mark-parc/edge-carrier-rev-b/GerberFiles/Transcode Report.txt

   ---- Transcoding 'C:\Users\dpaley\Documents\EAGLE\projects\Edge Carrier Board Rev B\Gerbers\CAMOutputs\GerberFiles\copper_inner_l2.gbr' ----   Mon Oct 25 11:11:18 2021

D10   --> D100
D13   --> D101
D14   --> D102
D15   --> D103
D16   --> D104
D17   --> D105
D18   --> D106
D19   --> D107
D20   --> D108
D21   --> D109
D22   --> D110
D23   --> D111
D24   --> D112
D25   --> D113
D26   --> D114
D27   --> D115
D28   --> D116
-----------------------------------------------------------------

   ---- Transcoding 'C:\Users\dpaley\Documents\EAGLE\projects\Edge Carrier Board Rev B\Gerbers\CAMOutputs\GerberFiles\copper_inner_l3.gbr' ----   Mon Oct 25 11:11:18 2021

D10   --> D117
D13   --> D118
D14   --> D119
D15   --> D120
D16   --> D121
D17   --> D122
D18   --> D123
D19   --> D124
D20   --> D125
D21   --> D126
D22   --> D127
D23   --> D128
D24   --> D129
D25   --> D130
D26   --> D131
D27   --> D132
D28   --> D133
D29   --> D134
D30   --> D135
-----------------------------------------------------------------

   ---- Transcoding 'C:\Users\dpaley\Documents\EAGLE\projects\Edge Carrier Board Rev B\Gerbers\CAMOutputs\GerberFiles\copper_top_l1.gbr' ----   Mon Oct 25 11:11:18 2021

D10   --> D136
D11   --> D137
D12   --> D138
D13   --> D139
D14   --> D140
D15   --> D141
D16   --> D142
D17   --> D143
D18   --> D144
D19   --> D145
D20   --> D146
D21   --> D147
D22   --> D148
D23   --> D149
D24   --> D150
D25   --> D151
D26   --> D152
D27   --> D153
D28   --> D154
D29   --> D155
D30   --> D156
D31   --> D157
D32   --> D158
D33   --> D159
D34   --> D160
D35   --> D161
D36   --> D162
D37   --> D163
D38   --> D164
D39   --> D165
D40   --> D166
D41   --> D167
D42   --> D168
D43   --> D169
D44   --> D170
-----------------------------------------------------------------

   ---- Transcoding 'C:\Users\dpaley\Documents\EAGLE\projects\Edge Carrier Board Rev B\Gerbers\CAMOutputs\GerberFiles\profile.gbr' ----   Mon Oct 25 11:11:18 2021

D10   --> D171
D11   --> D172
-----------------------------------------------------------------

   ---- Transcoding 'C:\Users\dpaley\Documents\EAGLE\projects\Edge Carrier Board Rev B\Gerbers\CAMOutputs\GerberFiles\silkscreen_top.gbr' ----   Mon Oct 25 11:11:18 2021

D10   --> D173
D11   --> D174
D12   --> D175
D13   --> D176
D14   --> D177
D15   --> D178
D16   --> D179
D17   --> D180
D18   --> D181
D19   --> D182
D20   --> D183
D21   --> D184
D22   --> D185
D23   --> D186
D24   --> D187
D25   --> D188
D26   --> D189
D27   --> D190
D28   --> D191
D29   --> D192
D30   --> D193
D31   --> D194
D32   --> D195
D33   --> D196
D34   --> D197
D35   --> D198
D36   --> D199
D37   --> D200
D38   --> D201
D39   --> D202
D40   --> D203
D41   --> D204
D42   --> D205
D43   --> D206
D44   --> D207
D45   --> D208
D46   --> D209
D47   --> D210
D48   --> D211
D49   --> D212
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
-----------------------------------------------------------------

   ---- Transcoding 'C:\Users\dpaley\Documents\EAGLE\projects\Edge Carrier Board Rev B\Gerbers\CAMOutputs\GerberFiles\soldermask_bottom.gbr' ----   Mon Oct 25 11:11:18 2021

D10   --> D294
D11   --> D295
D12   --> D296
D13   --> D297
D14   --> D298
D15   --> D299
D16   --> D300
D17   --> D301
D18   --> D302
D19   --> D303
D20   --> D304
D21   --> D305
D22   --> D306
D23   --> D307
D24   --> D308
D25   --> D309
D26   --> D310
D27   --> D311
D28   --> D312
D29   --> D313
D30   --> D314
D31   --> D315
D32   --> D316
D33   --> D317
D34   --> D318
D35   --> D319
D36   --> D320
D37   --> D321
D38   --> D322
D39   --> D323
D40   --> D324
-----------------------------------------------------------------

   ---- Transcoding 'C:\Users\dpaley\Documents\EAGLE\projects\Edge Carrier Board Rev B\Gerbers\CAMOutputs\GerberFiles\soldermask_top.gbr' ----   Mon Oct 25 11:11:18 2021

D10   --> D325
D11   --> D326
D12   --> D327
D13   --> D328
D14   --> D329
D15   --> D330
D16   --> D331
D17   --> D332
D18   --> D333
D19   --> D334
D20   --> D335
D21   --> D336
D22   --> D337
D23   --> D338
D24   --> D339
D25   --> D340
D26   --> D341
D27   --> D342
D28   --> D343
D29   --> D344
D30   --> D345
D31   --> D346
D32   --> D347
D33   --> D348
D34   --> D349
D35   --> D350
D36   --> D351
D37   --> D352
D38   --> D353
D39   --> D354
D40   --> D355
D41   --> D356
D42   --> D357
D43   --> D358
D44   --> D359
D45   --> D360
D46   --> D361
D47   --> D362
D48   --> D363
D49   --> D364
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
-----------------------------------------------------------------

   ---- Transcoding 'C:\Users\dpaley\Documents\EAGLE\projects\Edge Carrier Board Rev B\Gerbers\CAMOutputs\GerberFiles\solderpaste_top.gbr' ----   Mon Oct 25 11:11:18 2021

D10   --> D404
D11   --> D405
D12   --> D406
D13   --> D407
D14   --> D408
D15   --> D409
D16   --> D410
D17   --> D411
D18   --> D412
D19   --> D413
D20   --> D414
D21   --> D415
D22   --> D416
D23   --> D417
D24   --> D418
D25   --> D419
D26   --> D420
D27   --> D421
D28   --> D422
D29   --> D423
D30   --> D424
D31   --> D425
D32   --> D426
D33   --> D427
D34   --> D428
D35   --> D429
D36   --> D430
D37   --> D431
D38   --> D432
D39   --> D433
D40   --> D434
D41   --> D435
D42   --> D436
D43   --> D437
D44   --> D438
D45   --> D439
D46   --> D440
D47   --> D441
D48   --> D442
D49   --> D443
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
-----------------------------------------------------------------

   ---- Transcoding 'C:\Users\dpaley\Documents\EAGLE\projects\Edge Carrier Board Rev B\Gerbers\CAMOutputs\GerberFiles\copper_inner_l2.gbr' ----   Mon Oct 25 11:23:57 2021

D10   --> D450
D13   --> D451
D14   --> D452
D15   --> D453
D16   --> D454
D17   --> D455
D18   --> D456
D19   --> D457
D20   --> D458
D21   --> D459
D22   --> D460
D23   --> D461
D24   --> D462
D25   --> D463
D26   --> D464
D27   --> D465
D28   --> D466
-----------------------------------------------------------------

   ---- Transcoding 'C:\Users\dpaley\Documents\EAGLE\projects\Edge Carrier Board Rev B\Gerbers\CAMOutputs\GerberFiles\copper_inner_l3.gbr' ----   Mon Oct 25 11:23:57 2021

D10   --> D467
D13   --> D468
D14   --> D469
D15   --> D470
D16   --> D471
D17   --> D472
D18   --> D473
D19   --> D474
D20   --> D475
D21   --> D476
D22   --> D477
D23   --> D478
D24   --> D479
D25   --> D480
D26   --> D481
D27   --> D482
D28   --> D483
D29   --> D484
D30   --> D485
-----------------------------------------------------------------

   ---- Transcoding 'C:\Users\dpaley\Documents\EAGLE\projects\Edge Carrier Board Rev B\Gerbers\CAMOutputs\GerberFiles\copper_top_l1.gbr' ----   Mon Oct 25 11:23:57 2021

D10   --> D486
D11   --> D487
D12   --> D488
D13   --> D489
D14   --> D490
D15   --> D491
D16   --> D492
D17   --> D493
D18   --> D494
D19   --> D495
D20   --> D496
D21   --> D497
D22   --> D498
D23   --> D499
D24   --> D500
D25   --> D501
D26   --> D502
D27   --> D503
D28   --> D504
D29   --> D505
D30   --> D506
D31   --> D507
D32   --> D508
D33   --> D509
D34   --> D510
D35   --> D511
D36   --> D512
D37   --> D513
D38   --> D514
D39   --> D515
D40   --> D516
D41   --> D517
D42   --> D518
D43   --> D519
D44   --> D520
-----------------------------------------------------------------

   ---- Transcoding 'C:\Users\dpaley\Documents\EAGLE\projects\Edge Carrier Board Rev B\Gerbers\CAMOutputs\GerberFiles\profile.gbr' ----   Mon Oct 25 11:23:57 2021

D10   --> D521
D11   --> D522
-----------------------------------------------------------------

   ---- Transcoding 'C:\Users\dpaley\Documents\EAGLE\projects\Edge Carrier Board Rev B\Gerbers\CAMOutputs\GerberFiles\silkscreen_top.gbr' ----   Mon Oct 25 11:23:57 2021

D10   --> D523
D11   --> D524
D12   --> D525
D13   --> D526
D14   --> D527
D15   --> D528
D16   --> D529
D17   --> D530
D18   --> D531
D19   --> D532
D20   --> D533
D21   --> D534
D22   --> D535
D23   --> D536
D24   --> D537
D25   --> D538
D26   --> D539
D27   --> D540
D28   --> D541
D29   --> D542
D30   --> D543
D31   --> D544
D32   --> D545
D33   --> D546
D34   --> D547
D35   --> D548
D36   --> D549
D37   --> D550
D38   --> D551
D39   --> D552
D40   --> D553
D41   --> D554
D42   --> D555
D43   --> D556
D44   --> D557
D45   --> D558
D46   --> D559
D47   --> D560
D48   --> D561
D49   --> D562
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
-----------------------------------------------------------------

   ---- Transcoding 'C:\Users\dpaley\Documents\EAGLE\projects\Edge Carrier Board Rev B\Gerbers\CAMOutputs\GerberFiles\soldermask_bottom.gbr' ----   Mon Oct 25 11:23:57 2021

D10   --> D644
D11   --> D645
D12   --> D646
D13   --> D647
D14   --> D648
D15   --> D649
D16   --> D650
D17   --> D651
D18   --> D652
D19   --> D653
D20   --> D654
D21   --> D655
D22   --> D656
D23   --> D657
D24   --> D658
D25   --> D659
D26   --> D660
D27   --> D661
D28   --> D662
D29   --> D663
D30   --> D664
D31   --> D665
D32   --> D666
D33   --> D667
D34   --> D668
D35   --> D669
D36   --> D670
D37   --> D671
D38   --> D672
D39   --> D673
D40   --> D674
-----------------------------------------------------------------

   ---- Transcoding 'C:\Users\dpaley\Documents\EAGLE\projects\Edge Carrier Board Rev B\Gerbers\CAMOutputs\GerberFiles\soldermask_top.gbr' ----   Mon Oct 25 11:23:57 2021

D10   --> D675
D11   --> D676
D12   --> D677
D13   --> D678
D14   --> D679
D15   --> D680
D16   --> D681
D17   --> D682
D18   --> D683
D19   --> D684
D20   --> D685
D21   --> D686
D22   --> D687
D23   --> D688
D24   --> D689
D25   --> D690
D26   --> D691
D27   --> D692
D28   --> D693
D29   --> D694
D30   --> D695
D31   --> D696
D32   --> D697
D33   --> D698
D34   --> D699
D35   --> D700
D36   --> D701
D37   --> D702
D38   --> D703
D39   --> D704
D40   --> D705
D41   --> D706
D42   --> D707
D43   --> D708
D44   --> D709
D45   --> D710
D46   --> D711
D47   --> D712
D48   --> D713
D49   --> D714
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
-----------------------------------------------------------------

   ---- Transcoding 'C:\Users\dpaley\Documents\EAGLE\projects\Edge Carrier Board Rev B\Gerbers\CAMOutputs\GerberFiles\solderpaste_top.gbr' ----   Mon Oct 25 11:23:57 2021

D10   --> D754
D11   --> D755
D12   --> D756
D13   --> D757
D14   --> D758
D15   --> D759
D16   --> D760
D17   --> D761
D18   --> D762
D19   --> D763
D20   --> D764
D21   --> D765
D22   --> D766
D23   --> D767
D24   --> D768
D25   --> D769
D26   --> D770
D27   --> D771
D28   --> D772
D29   --> D773
D30   --> D774
D31   --> D775
D32   --> D776
D33   --> D777
D34   --> D778
D35   --> D779
D36   --> D780
D37   --> D781
D38   --> D782
D39   --> D783
D40   --> D784
D41   --> D785
D42   --> D786
D43   --> D787
D44   --> D788
D45   --> D789
D46   --> D790
D47   --> D791
D48   --> D792
D49   --> D793
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
-----------------------------------------------------------------

   ---- Transcoding 'C:\Users\dpaley\Documents\EAGLE\projects\Edge Carrier Board Rev B\Gerbers\CAMOutputs\GerberFiles\copper_inner_l2.gbr' ----   Mon Oct 25 11:24:54 2021

D10   --> D100
D13   --> D101
D14   --> D102
D15   --> D103
D16   --> D104
D17   --> D105
D18   --> D106
D19   --> D107
D20   --> D108
D21   --> D109
D22   --> D110
D23   --> D111
D24   --> D112
D25   --> D113
D26   --> D114
D27   --> D115
D28   --> D116
-----------------------------------------------------------------

   ---- Transcoding 'C:\Users\dpaley\Documents\EAGLE\projects\Edge Carrier Board Rev B\Gerbers\CAMOutputs\GerberFiles\copper_inner_l3.gbr' ----   Mon Oct 25 11:24:54 2021

D10   --> D117
D13   --> D118
D14   --> D119
D15   --> D120
D16   --> D121
D17   --> D122
D18   --> D123
D19   --> D124
D20   --> D125
D21   --> D126
D22   --> D127
D23   --> D128
D24   --> D129
D25   --> D130
D26   --> D131
D27   --> D132
D28   --> D133
D29   --> D134
D30   --> D135
-----------------------------------------------------------------

   ---- Transcoding 'C:\Users\dpaley\Documents\EAGLE\projects\Edge Carrier Board Rev B\Gerbers\CAMOutputs\GerberFiles\copper_top_l1.gbr' ----   Mon Oct 25 11:24:54 2021

D10   --> D136
D11   --> D137
D12   --> D138
D13   --> D139
D14   --> D140
D15   --> D141
D16   --> D142
D17   --> D143
D18   --> D144
D19   --> D145
D20   --> D146
D21   --> D147
D22   --> D148
D23   --> D149
D24   --> D150
D25   --> D151
D26   --> D152
D27   --> D153
D28   --> D154
D29   --> D155
D30   --> D156
D31   --> D157
D32   --> D158
D33   --> D159
D34   --> D160
D35   --> D161
D36   --> D162
D37   --> D163
D38   --> D164
D39   --> D165
D40   --> D166
D41   --> D167
D42   --> D168
D43   --> D169
D44   --> D170
-----------------------------------------------------------------

   ---- Transcoding 'C:\Users\dpaley\Documents\EAGLE\projects\Edge Carrier Board Rev B\Gerbers\CAMOutputs\GerberFiles\profile.gbr' ----   Mon Oct 25 11:24:54 2021

D10   --> D171
D11   --> D172
-----------------------------------------------------------------

   ---- Transcoding 'C:\Users\dpaley\Documents\EAGLE\projects\Edge Carrier Board Rev B\Gerbers\CAMOutputs\GerberFiles\silkscreen_top.gbr' ----   Mon Oct 25 11:24:54 2021

D10   --> D173
D11   --> D174
D12   --> D175
D13   --> D176
D14   --> D177
D15   --> D178
D16   --> D179
D17   --> D180
D18   --> D181
D19   --> D182
D20   --> D183
D21   --> D184
D22   --> D185
D23   --> D186
D24   --> D187
D25   --> D188
D26   --> D189
D27   --> D190
D28   --> D191
D29   --> D192
D30   --> D193
D31   --> D194
D32   --> D195
D33   --> D196
D34   --> D197
D35   --> D198
D36   --> D199
D37   --> D200
D38   --> D201
D39   --> D202
D40   --> D203
D41   --> D204
D42   --> D205
D43   --> D206
D44   --> D207
D45   --> D208
D46   --> D209
D47   --> D210
D48   --> D211
D49   --> D212
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
-----------------------------------------------------------------

   ---- Transcoding 'C:\Users\dpaley\Documents\EAGLE\projects\Edge Carrier Board Rev B\Gerbers\CAMOutputs\GerberFiles\soldermask_bottom.gbr' ----   Mon Oct 25 11:24:54 2021

D10   --> D294
D11   --> D295
D12   --> D296
D13   --> D297
D14   --> D298
D15   --> D299
D16   --> D300
D17   --> D301
D18   --> D302
D19   --> D303
D20   --> D304
D21   --> D305
D22   --> D306
D23   --> D307
D24   --> D308
D25   --> D309
D26   --> D310
D27   --> D311
D28   --> D312
D29   --> D313
D30   --> D314
D31   --> D315
D32   --> D316
D33   --> D317
D34   --> D318
D35   --> D319
D36   --> D320
D37   --> D321
D38   --> D322
D39   --> D323
D40   --> D324
-----------------------------------------------------------------

   ---- Transcoding 'C:\Users\dpaley\Documents\EAGLE\projects\Edge Carrier Board Rev B\Gerbers\CAMOutputs\GerberFiles\soldermask_top.gbr' ----   Mon Oct 25 11:24:54 2021

D10   --> D325
D11   --> D326
D12   --> D327
D13   --> D328
D14   --> D329
D15   --> D330
D16   --> D331
D17   --> D332
D18   --> D333
D19   --> D334
D20   --> D335
D21   --> D336
D22   --> D337
D23   --> D338
D24   --> D339
D25   --> D340
D26   --> D341
D27   --> D342
D28   --> D343
D29   --> D344
D30   --> D345
D31   --> D346
D32   --> D347
D33   --> D348
D34   --> D349
D35   --> D350
D36   --> D351
D37   --> D352
D38   --> D353
D39   --> D354
D40   --> D355
D41   --> D356
D42   --> D357
D43   --> D358
D44   --> D359
D45   --> D360
D46   --> D361
D47   --> D362
D48   --> D363
D49   --> D364
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
-----------------------------------------------------------------

   ---- Transcoding 'C:\Users\dpaley\Documents\EAGLE\projects\Edge Carrier Board Rev B\Gerbers\CAMOutputs\GerberFiles\solderpaste_top.gbr' ----   Mon Oct 25 11:24:54 2021

D10   --> D404
D11   --> D405
D12   --> D406
D13   --> D407
D14   --> D408
D15   --> D409
D16   --> D410
D17   --> D411
D18   --> D412
D19   --> D413
D20   --> D414
D21   --> D415
D22   --> D416
D23   --> D417
D24   --> D418
D25   --> D419
D26   --> D420
D27   --> D421
D28   --> D422
D29   --> D423
D30   --> D424
D31   --> D425
D32   --> D426
D33   --> D427
D34   --> D428
D35   --> D429
D36   --> D430
D37   --> D431
D38   --> D432
D39   --> D433
D40   --> D434
D41   --> D435
D42   --> D436
D43   --> D437
D44   --> D438
D45   --> D439
D46   --> D440
D47   --> D441
D48   --> D442
D49   --> D443
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
-----------------------------------------------------------------
