mark-parc/edge-carrier-rev-b/block diagram.pptx

CM4 Module
(sheet 1)

Ethernet
(sheet 2,9,10)

USB
(sheet 7)

RTC
(sheet6)

Debug
(HDMI/USB OTG)
(sheet 3,6)

Power Regulation
Watchdog
(sheet 5,8)
