mark-parc/edge-carrier-rev-b/Assembly/Compute Module BOM.xlsx

Qty | Parts | Value | Description | DIGIKEY | MANUFACTURER | MOUSER | MPN | Device
2 | R34, R35 |  | Generic Resistor Package | 311-0.0ARCT-ND |  |  | RC0805JR-070RL | EDGE-LIBRARY_RESISTOR0805
28 | C2, C3, C8, C9, C28, C29, C30, C33, C34, C35, C36, C37, C38, C43, C45, C56, C57, C59, C60, C61, C62, C63, C65, C66, C67, C74, C78, C94 | 0.1uF | Capacitor - Generic | 399-3521-1-ND | Kemet |  | C0402C104K4RACTU | EDGE-LIBRARY_TUTORIAL---FUSION-360_CCHIP-0402(1005-METRIC)
1 | R10 | 10.5k | Resistor Fixed - ANSI | YAG2951CT-ND | Yageo |  | RC0402FR-0710K5L | EDGE-LIBRARY_TUTORIAL---FUSION-360_R-USCHIP-0402(1005-METRIC)
5 | C6, C7, C42, C75, C95 | 10000pF | Capacitor - Generic | 1253-CM02X5R103M16AHCT-ND | AVX Corporation |  | CM02X5R103M16AH | EDGE-LIBRARY_TUTORIAL---FUSION-360_CCHIP-0402(1005-METRIC)
1 | C23 | 100uF | Wurth Elektronik 100uF 6.3V dc Aluminium Polymer Capacitor, Surface Mount 7.3 x 4.3 x 1.9mm +105C 7.3mm | 732-13327-1-nd | Wurth Elektronik | 710-875015119003 | 875015119003 | 875015119003
6 | R9, R33, R40, R51, R53, R55 | 10k | Resistor Fixed - ANSI | 2571-RM04J103CTTR-ND | CAL-CHIP ELECTRONICS, INC. |  | RM04J103CT | EDGE-LIBRARY_TUTORIAL---FUSION-360_R-USCHIP-0402(1005-METRIC)
1 | C44 | 10pF | Capacitor - Generic | 399-3521-1-ND | Kyocera Avx |  | 478-04026D100JAT2ACT-ND | EDGE-LIBRARY_TUTORIAL---FUSION-360_CCHIP-0402(1005-METRIC)
13 | C4, C5, C10, C25, C26, C27, C31, C32, C41, C47, C64, C76, C96 | 10uF | Capacitor - Generic | 490-14381-1-ND | Murata Electronics |  | GRM21BR71A106KA73K | EDGE-LIBRARY_TUTORIAL---FUSION-360_CCHIP-0402(1005-METRIC)
2 | R14, R28 | 115k | Resistor Fixed - ANSI | A127517CT-ND | TE Connectivity |  | RP73PF1E115KBTD | EDGE-LIBRARY_TUTORIAL---FUSION-360_R-USCHIP-0402(1005-METRIC)
1 | R52 | 12k | Resistor Fixed - ANSI | 311-12.0KLRCT-ND | Stackpole Electronics Inc |  | RC0402FR-0712KL | EDGE-LIBRARY_TUTORIAL---FUSION-360_R-USCHIP-0402(1005-METRIC)
3 | R8, R26, R29 | 12k | Resistor Fixed - ANSI | 311-12.0KLRCT-ND | Yageo |  | RC0402FR-0712KL | EDGE-LIBRARY_TUTORIAL---FUSION-360_R-USCHIP-0402(1005-METRIC)
1 | C46 | 12pF | Capacitor - Generic | 478-04026A120KAT2ACT-ND | Kyocera Avx |  | 04026A120KAT2A | EDGE-LIBRARY_TUTORIAL---FUSION-360_CCHIP-0402(1005-METRIC)
3 | R2, R11, R36 | 15.8k | Resistor Fixed - ANSI | 541-15.8KLCT-ND | Vishay Dale |  | CRCW040215K8FKED | EDGE-LIBRARY_TUTORIAL---FUSION-360_R-USCHIP-0402(1005-METRIC)
1 | R16 | 15k | Resistor Fixed - ANSI | RMCF0402FT15K0CT-ND | Stackpole Electronics Inc |  | RMCF0402FT15K0 | EDGE-LIBRARY_TUTORIAL---FUSION-360_R-USCHIP-0402(1005-METRIC)
2 | C48, C73 | 15pF | Capacitor - Generic | 2571-GMC04CG150J50NTTR-ND | CAL-CHIP ELECTRONICS, INC. |  | GMC04CG150J50NT | EDGE-LIBRARY_TUTORIAL---FUSION-360_CCHIP-0402(1005-METRIC)
2 | C54, C55 | 16pF | Capacitor - Generic | 399-C0402C160K3HACAUTOCT-ND | Kemet |  | C0402C160K3HACAUTO | EDGE-LIBRARY_TUTORIAL---FUSION-360_CCHIP-0402(1005-METRIC)
1 | X1 | 1751248 | MKDS 1/ 2-3,5 Printklemme |  |  |  |  | 1751248
4 | C77, C79, C80, C82 | 1uF | Capacitor - Generic | 2873-C0402B105K016TCT-ND | Holy Stone Enterprise Co., Ltd. |  | C0402B105K016T | EDGE-LIBRARY_TUTORIAL---FUSION-360_CCHIP-0402(1005-METRIC)
2 | R24, R25 | 2.2k | Resistor Fixed - ANSI | 2571-RM04J222CTTR-ND | CAL-CHIP ELECTRONICS, INC. |  | RM04J222CT | EDGE-LIBRARY_TUTORIAL---FUSION-360_R-USCHIP-0402(1005-METRIC)
1 | J2 | 2011-1X03G00SD025B | PIN HEADER | 2553-2011-1X03G00SB-ND | Oupiin |  | 2011-1X03G00SB | CON-LSTB_MA03-1
1 | J4 | 2011-2X07G00SB | PIN HEADER | 2553-2011-2X07G00SB-ND | Oupiin |  | 2011-2X07G00SB | CON-LSTB_MA07-2
4 | R3, R15, R32, R38 | 22.1k | Resistor Fixed - ANSI | 2571-RN04D2212CT10-25TR-ND | CAL-CHIP ELECTRONICS, INC. |  | RN04D2212CT10-25 | EDGE-LIBRARY_TUTORIAL---FUSION-360_R-USCHIP-0402(1005-METRIC)
1 | R13 | 22k | Resistor Fixed - ANSI | 2571-RM04J222CTTR-ND | CAL-CHIP ELECTRONICS, INC. |  | RM04J223CT | EDGE-LIBRARY_TUTORIAL---FUSION-360_R-USCHIP-0402(1005-METRIC)
19 | C1, C17, C18, C19, C20, C21, C22, C24, C51, C52, C53, C68, C69, C70, C81, C87, C88, C89, C90 | 22uF | Capacitor - Generic | 2571-GMC04X5R226M6R3NTTR-ND | CAL-CHIP ELECTRONICS, INC. |  | GMC04X5R226M6R3NT | EDGE-LIBRARY_TUTORIAL---FUSION-360_CCHIP-0402(1005-METRIC)
1 | J13 | 2553-2011-1X03G00SB-ND | PIN HEADER | 2553-2011-1X03G00SB-ND | Oupiin |  | 2011-1X03G00SB | CON-LSTB_MA03-1
5 | C13, C14, C49, C72, C92 | 2700pF | Capacitor - Generic | 2571-GMC04X5R272M50NTTR-ND | CAL-CHIP ELECTRONICS, INC. |  | GMC04X5R272M50NT | EDGE-LIBRARY_TUTORIAL---FUSION-360_CCHIP-0402(1005-METRIC)
2 | C39, C40 | 27pF | Capacitor - Generic | 490-17672-1-ND | Murata Electronics |  | GJM1555C1H270JB01D | EDGE-LIBRARY_TUTORIAL---FUSION-360_CCHIP-0402(1005-METRIC)
1 | R54 | 2k | Resistor Fixed - ANSI | RMCF0402JT2K00CT-ND | Stackpole Electronics Inc |  | RMCF0402JT2K00 | EDGE-LIBRARY_TUTORIAL---FUSION-360_R-USCHIP-0402(1005-METRIC)
1 | L7 | 3.3uH 1.5A 70m | SMT Power Inductor | 732-5494-1-ND | Wurth Elektronik |  | 74404032033 | 74404032033
2 | R1, R31 | 309k | Resistor Fixed - ANSI | 2571-RM04F3093CTTR-ND | CAL-CHIP ELECTRONICS, INC. |  | RM04F3093CT | EDGE-LIBRARY_TUTORIAL---FUSION-360_R-USCHIP-0402(1005-METRIC)
1 | D1 | 30V 200MA | Schottky Diodes | BAT54C-FDICT-ND | Diodes Incorporated |  | BAT54C-7-F | EDGE-LIBRARY_BAT54C
2 | C12, C93 | 33pF | Capacitor - Generic | 2571-GMC04CG330J16NTTR-ND | CAL-CHIP ELECTRONICS, INC. |  | GMC04CG330J16NT | EDGE-LIBRARY_TUTORIAL---FUSION-360_CCHIP-0402(1005-METRIC)
4 | R21, R22, R23, R27 | 36k | Resistor Fixed - ANSI | 311-36.0KLRCT-ND | Yageo |  | RC0402FR-0736KL | EDGE-LIBRARY_TUTORIAL---FUSION-360_R-USCHIP-0402(1005-METRIC)
1 | R30 | 37.4k | Resistor Fixed - ANSI | 2571-RM04F3742CTTR-ND | CAL-CHIP ELECTRONICS, INC. |  | RM04F3742CT | EDGE-LIBRARY_TUTORIAL---FUSION-360_R-USCHIP-0402(1005-METRIC)
10 | R4, R5, R6, R7, R17, R18, R41, R48, R49, R50 | 470 | Resistor Fixed - ANSI | 311-470LRCT-ND | Yageo |  | RC0402FR-07470RL | EDGE-LIBRARY_TUTORIAL---FUSION-360_R-USCHIP-0402(1005-METRIC)
2 | R19, R20 | 510k | Resistor Fixed - ANSI | RMCF0402JT510KCT-ND | Stackpole Electronics Inc |  | RMCF0402JT510K | EDGE-LIBRARY_TUTORIAL---FUSION-360_R-USCHIP-0402(1005-METRIC)
1 | C11 | 56pF | Capacitor - Generic | 587-6134-1-ND | Taiyo Yuden |  | EMK042CG560JC-W | EDGE-LIBRARY_TUTORIAL---FUSION-360_CCHIP-0402(1005-METRIC)
1 | J6 | 67996-140HLF | AMPHENOL ICC (FCI) - 67996-140HLF - CONNECTOR, HEADER, 40POS, 2ROW, 2.54MM | 609-4925-ND | Amphenol | 649-67996-140HLF | 67996-140HLF | 67996-140HLF
1 | R12 | 69.8k | Resistor Fixed - ANSI | RMCF0402FT69K8CT-ND | Stackpole Electronics Inc |  | RMCF0402FT69K8 | EDGE-LIBRARY_TUTORIAL---FUSION-360_R-USCHIP-0402(1005-METRIC)
4 | C83, C84, C85, C86 | DNP | Capacitor - Generic | 399-3521-1-ND | Kemet |  | C0402C104K4RACTU | EDGE-LIBRARY_TUTORIAL---FUSION-360_CCHIP-0402(1005-METRIC)
5 | C15, C16, C50, C71, C91 | DNP | Capacitor - Generic |  |  |  |  | EDGE-LIBRARY_TUTORIAL---FUSION-360_CCHIP-0402(1005-METRIC)
2 | U4, U11 | EDGE-LIBRARY_74LVC1G07SE-7 | Check prices | 74LVC1G07SE-7DICT-ND | Diodes Inc |  | 74LVC1G07SE-7 | EDGE-LIBRARY_74LVC1G07SE-7
1 | Y2 | EDGE-LIBRARY_ABM8-24.000MHZ-B2-T_ABM8-24.000MHZ-B2-T | Crystal 24MHz Â±20ppm (Tol) Â±30ppm (Stability) 18pF FUND 80Ohm 4-Pin Mini-CSMD T/R | 535-9138-1-ND | Abracon |  | ABM8-24.000MHZ-B2-T | EDGE-LIBRARY_ABM8-24.000MHZ-B2-T_ABM8-24.000MHZ-B2-T
1 | U9 | EDGE-LIBRARY_AP2553AW6-7 |  | 31-AP22653AW6-7CT-ND | Diodes Incorporated |  | AP22653AW6-7 | EDGE-LIBRARY_AP2553AW6-7
5 | U3, U7, U8, U15, U20 | EDGE-LIBRARY_AP64501_AP64501 |  | AP64501SP-13CT-ND | Diodes Incorporated |  | AP64501SP-13 | EDGE-LIBRARY_AP64501_AP64501
1 | BT1 | EDGE-LIBRARY_BATTERY_HOLDER | BATTERY RETAINER COIN 20MM SMD | 732-12323-2-ND | Wurth Electronics Inc. |  | 79523141 | EDGE-LIBRARY_BATTERY_HOLDER
1 | J7 | EDGE-LIBRARY_HDMI_CONNECTOR_RT_SMA | HDMI Connector | Right Angle | Without Flange | -20C to 85C | 380-SS-53000-001-ND | Stewart Connector |  | SS-53000-001 | EDGE-LIBRARY_HDMI_CONNECTOR_RT_SMA
2 | J5, J17 | EDGE-LIBRARY_L836-1J1T-43_L836-1J1T-43 | 1X1 | GIGABIT | Tab Down | Low Profile | With LED | 507-2236-ND | Bel Magnetic Solutions |  | L836-1J1T-43 | EDGE-LIBRARY_L836-1J1T-43_L836-1J1T-43
1 | D3 | EDGE-LIBRARY_MMBZ5242BLT3G | Diode Ziner 12V 225mW SOT23-3 | MMBZ5242BLT3GOSCT-ND | On Semiconductor |  | MMBZ5242BLT3G | EDGE-LIBRARY_MMBZ5242BLT3G
1 | J9 | EDGE-LIBRARY_PCIE_CONNECTOR_36POS | Conn PCI Express Card Edge SKT 36 POS 2mm Solder ST Thru-Hole Tray | 609-2029-ND | Amphenol ICC |  | 10018784-10210TLF | EDGE-LIBRARY_PCIE_CONNECTOR_36POS
2 | MOD1 | EDGE-LIBRARY_RPI-CM4 |  | H11615CT-ND | Hirose Electric Co Ltd |  | DF40C-0.4V(51) | EDGE-LIBRARY_RPI-CM4
3 | L1, L3, L4 | EDGE-LIBRARY_SRN6045TA-3R3Y_SRN6045TA-3R3Y | Inductor Power Semi-Shielded Wirewound 220uH 20% 1MHz 15Q-Factor Ferrite 600mA 900mOhm DCR 2424 Automotive T/R | SRN6045TA-3R3YCT-ND | Bourns |  | SRN6045TA-3R3Y | EDGE-LIBRARY_SRN6045TA-3R3Y_SRN6045TA-3R3Y
2 | L2, L5 | EDGE-LIBRARY_SRN6045TA-3R3Y_SRN6045TA-3R3Y | Inductor Power Semi-Shielded Wirewound 220uH 20% 1MHz 15Q-Factor Ferrite 600mA 900mOhm DCR 2424 Automotive T/R | SRN6045TA-6R8MCT-ND | Bourns |  | SRN6045TA-6R8M | EDGE-LIBRARY_SRN6045TA-3R3Y_SRN6045TA-3R3Y
6 | U1, U2, U12, U18, U19, U21 | EDGE-LIBRARY_TPD4EUSB30DQAR_TPD4EUSB30DQAR | 4-channel ESD solution for SuperSpeed (6 Gbps) USB 3.0 interface 10-USON -40 to 85 | 296-28063-1-ND | Texas Instruments |  | TPD4EUSB30DQAR | EDGE-LIBRARY_TPD4EUSB30DQAR_TPD4EUSB30DQAR
1 | U13 | EDGE-LIBRARY_USB2514B-I_M2_USB2514B-I/M2 | None Check prices | USB2514B-I/M2-ND | Microchip |  | USB2514B-I/M2 | EDGE-LIBRARY_USB2514B-I_M2_USB2514B-I/M2
1 | J14 | EDGE-LIBRARY_USB_A_2PORT_STACKED_SMA | Conn USB Type A RCP 4/4 POS Solder RA Thru-Hole 8 Terminal 2 Port Tray | WM17130-ND | Molex |  | 672984090 | EDGE-LIBRARY_USB_A_2PORT_STACKED_SMA
1 | U14 | FSUSB42UMX | IC, Fairchild, FSUSB42UMX |  |  |  |  | FSUSB42UMX
2 | J3, J16 | L712RAS_L712RAS | Power Barrel Connector Jack 2.50mm ID (0.098), 5.50mm OD (0.217") Panel Mount, Through Hole, Right Angle Check prices" | SC1394-ND | Switchcraft |  | L712RAS | L712RAS_L712RAS
1 | U16 | LAN7800-I_VSX | USB Interface IC USB3.1 Gen1 to 10/100/1000 Ethernet Bridge, Industrial temp. | LAN7800-I/VSX-ND | Microchip |  | LAN7800-I/VSX | LAN7800-I_VSX
4 | LED1, LED2, LED3, LED4 | LTST-S270KGKT | LED | LTST-S270KGKT | Lite-On Inc |  | LTST-S270KGKT | LED_LEDCHIP-LED0603
1 | U10 | MCP7940N-E_MS | Real Time Clock I2C GP RTCC 64B SRAM , EXT | MCP7940NT-E/MSCT-ND | Microchip | 579-MCP7940N-E/MS | MCP7940N-E/MS | MCP7940N-E_MS
1 | U5 | MIC2025-2YMM | Power Switch ICs - Power Distribution USB High-Side Power Switch | MIC2025-2YM-CT-ND | Microchip | 998-MIC2025-2YMM | MIC2025-2YMM | MIC2025-2YMM
7 | MGT7, MGT8, MGT9, MGT10, MGT11, MGT12, MGT13 | MOUNTING_HOLE | Chassis Mounting Hole w/GND connection ability |  |  |  |  | MOUNTING_HOLE
7 | MGT1, MGT2, MGT3, MGT4, MGT5, MGT6, MGT14 | MOUNTING_HOLE | Chassis Mounting Hole w/GND connection ability | DNP |  |  |  | MOUNTING_HOLE
1 | JP1 | PINHD-2X5 | PIN HEADER | 2553-2011-2X05G00SB-ND | Oupiin |  | 2011-2X05G00SB | PINHD-2X5
1 | Q2 | RQ3E120ATTB | RQ3E100ATTB P-Channel MOSFET, 31 A, 30 V RQ3E100AT, 8-Pin HSMT ROHM | RQ3E120ATTBCT-ND | ROHM Semiconductor | 755-RQ3E100ATTB | RQ3E100ATTB | RQ3E120ATTB
1 | U17 | SAMACSYS_PARTS_93AA66AT-I_OT | 4K, 512 X 8 SERIAL EEPROM,1.8V,IND | 93AA66AT-I/OTCT-ND | Microchip |  | 93AA66AT-I/OT | SAMACSYS_PARTS_93AA66AT-I_OT
1 | Y3 | SAMACSYS_PARTS_ABM8G-25.000MHZ-B4Y-T3 | ABRACON - ABM8G-25.000MHZ-B4Y-T3 - CRYSTAL, 25MHZ, 10PF, 3.2MM X 2.5MM | 535-14315-1-ND | ABRACON |  | ABM8G-25.000MHZ-B4Y-T3 | SAMACSYS_PARTS_ABM8G-25.000MHZ-B4Y-T3
1 | FB6 | SAMACSYS_PARTS_BLM18PG121SN1D | Ferrite bead SMD 0603 120R 2A Murata Ferrite Bead (Chip Ferrite Bead), 1.6 x 0.8 x 0.8mm (0603), 120 impedance at 100 MHz | 490-1037-1-ND | Murata Electronics |  | BLM18PG121SN1D | SAMACSYS_PARTS_BLM18PG121SN1D
1 | U6 | SAMACSYS_PARTS_TPS3850G33DRCT | Precision window supervisor for OV & UV monitoring with window watchdog timer & programmable delay | 2156-TPS3850G33DRCR-ND | Texas Instruments |  | TPS3850G33DRCT | SAMACSYS_PARTS_TPS3850G33DRCT
3 | LED5, LED6, LED7 | TLPR5600 | LED S.VIEW RED TINT. DIFF-e4 | DNP | Vishay | DNP | TLPR5600 | TLPR5600
1 | J19 | TSW-103-07-L-T | CONN HEADER 9 POS .100";";";";";";SAM15360-ND" |  |  |  |  | TSW-103-07-L-T
3 | FB1, FB2, FB3 | WLBD2012HCU121TH791-WLBD2012HCU121TH | Ferrite bead SMD 0603 120R 2A Murata Ferrite Bead (Chip Ferrite Bead), 1.6 x 0.8 x 0.8mm (0603), 120 impedance at 100 MHz |  | Waisin | 791-WLBD2012HCU121TH | WLBD2012HCU121TH | WLBD2012HCU121TH791-WLBD2012HCU121TH
1 | Y1 | XTAL32.7682-SMD |  | 3003-QT3C-32.768KDZY-T-ND | QST |  | QT3C-32.768KDZY-T | XTAL32.7682-SMD
1 | J18 | ZX62-B-5PA_33_ | USB Connectors MICRO B RECEPT RA SMT BTTM MNT | H125270CT-ND | Hirose |  | ZX62-B-5PA(33) | ZX62-B-5PA_33_
