mark-parc/edge-carrier-rev-b/Compute Module.dxf

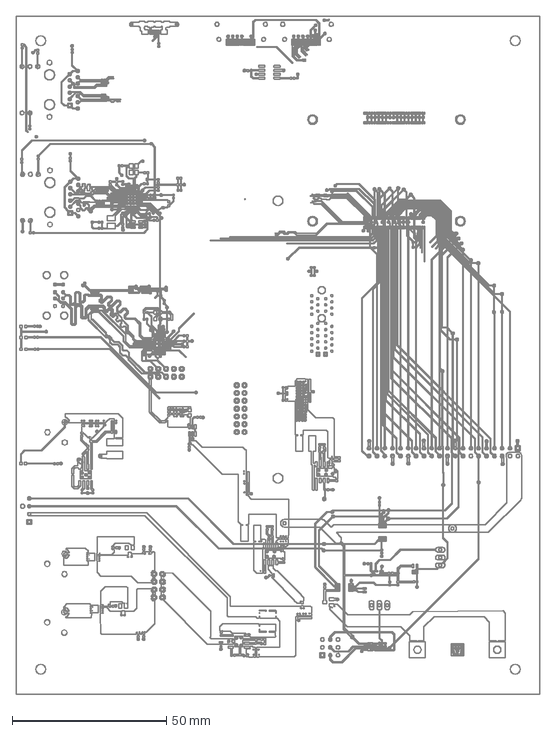
[picture p2: CAD file, 2022-02-08]
Compute Module.dxf
170.0 x 220.0 mm
