mark-parc/edge-carrier-rev-b/Release Notes.rtf

Release Notes (starting with Board Rev B)

DNP: 7/8/2021 –
Incorrect parts specified for U5, J18, and 22uF caps. The only one I cannot fix is the U5 (MIC2025) as the footprint of the part I have is an SOIC and not 8MSOP. Board was modified to change this footprint
Polygon thermals were turned off. This closes the gap around pins and vias.
MAS: 12/13/2021 –
- Moved U5 to the ground plane.
- Re routed HDMI0 signals away from HDMI housing for static isolation.
- Changed 5v optical supply to 12v 3A supply. U3 area.
