mark-parc/edge-carrier-rev-b/Compute Module Top Assembly.pdf

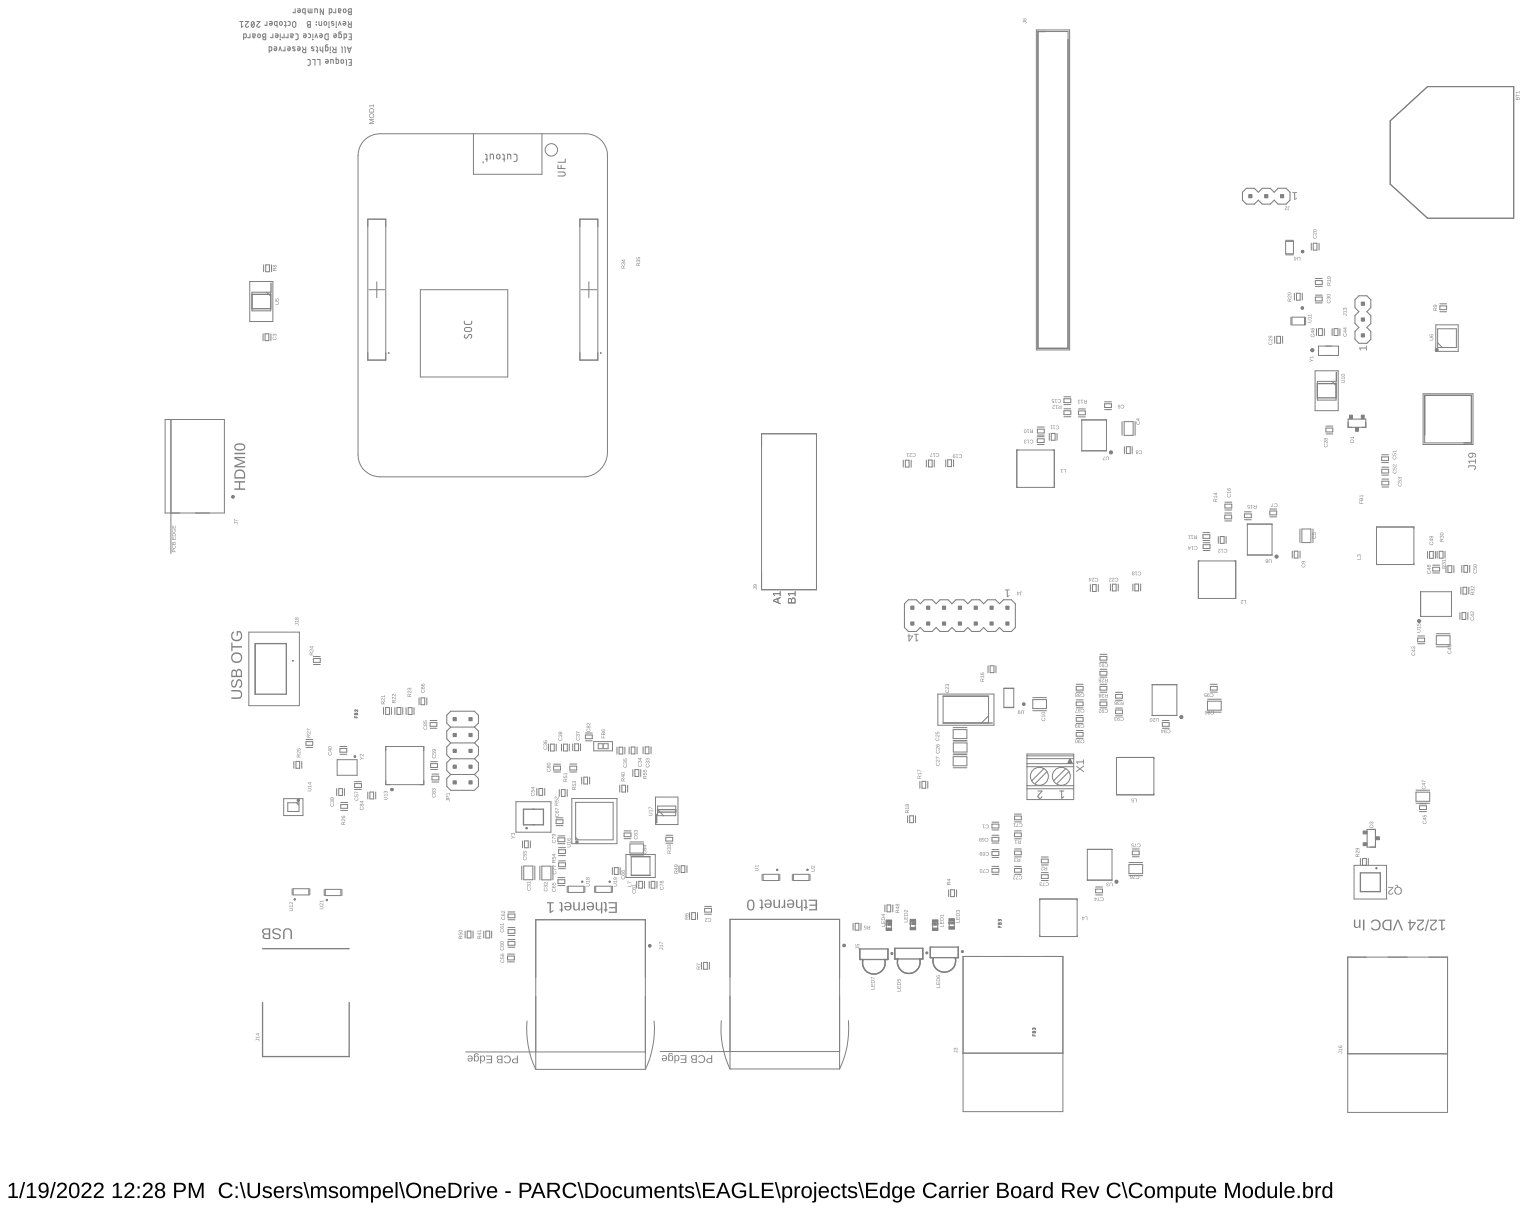
[picture p13: page 1]
