mark-parc/edge-carrier-rev-b/Compute Module All Layers.pdf

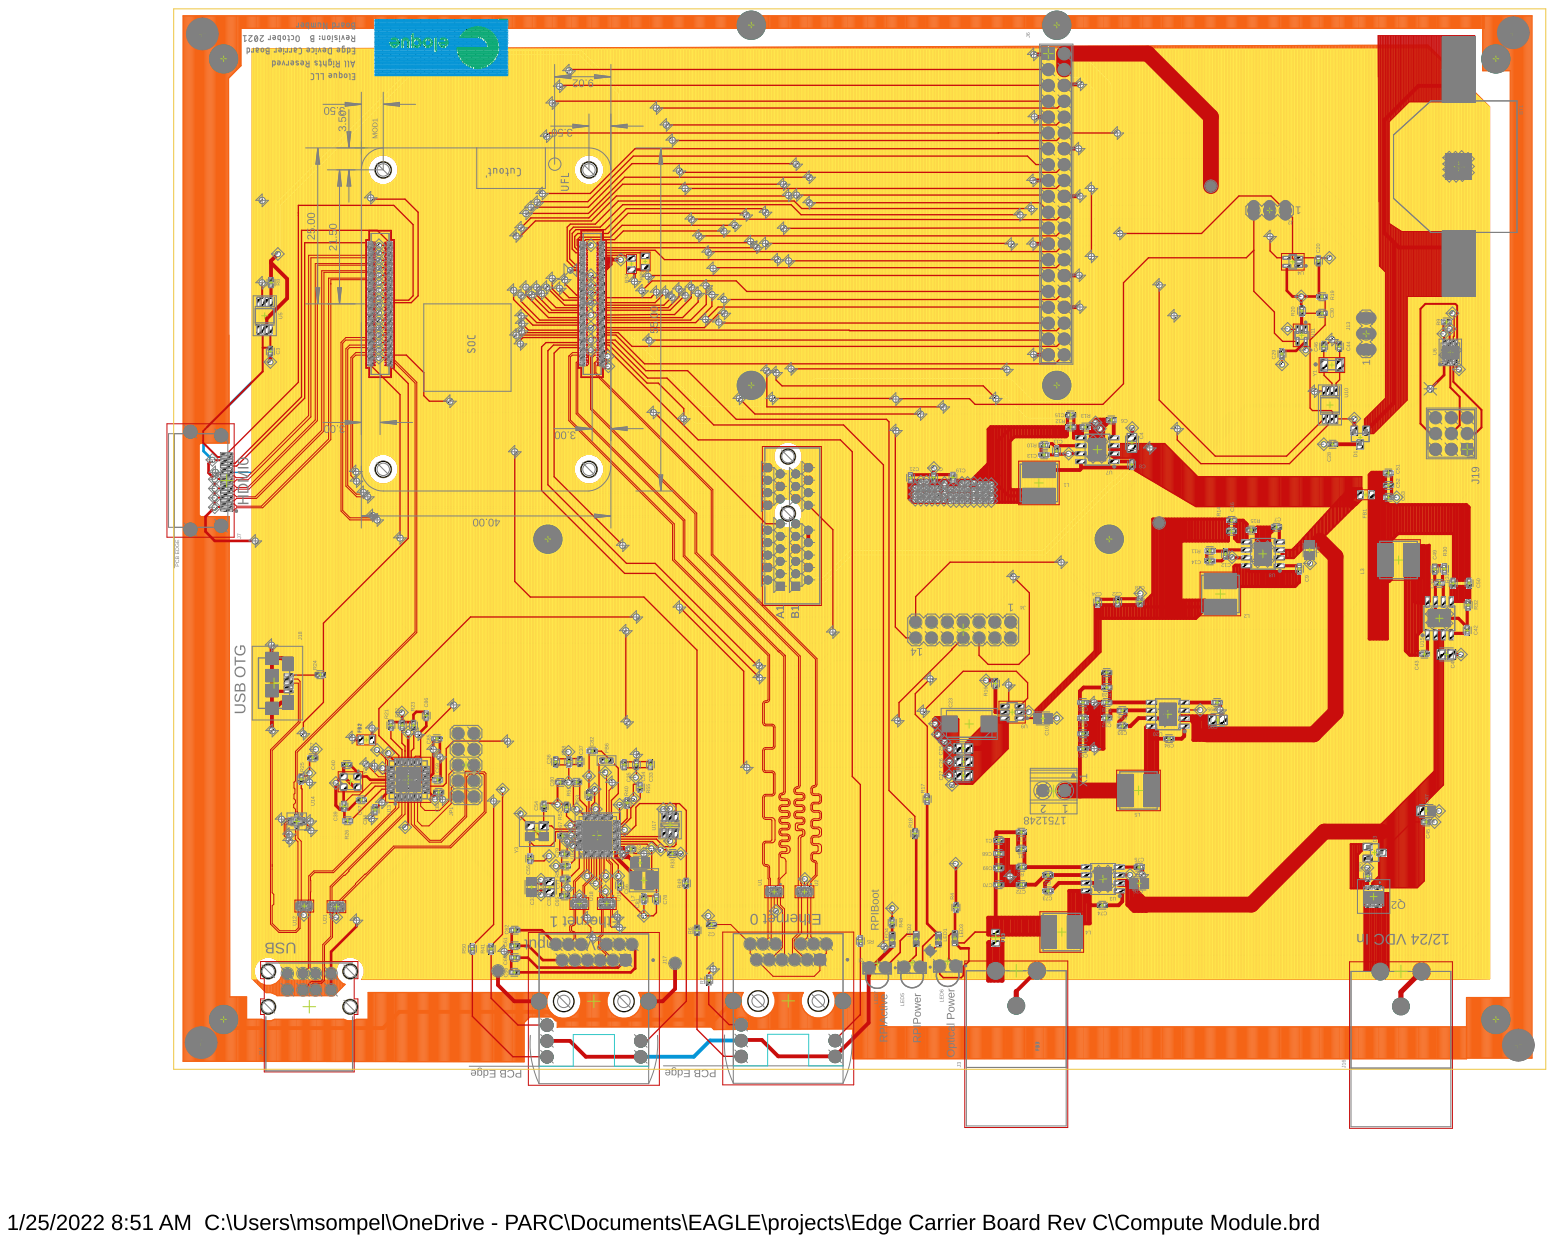
[picture p14: page 1]
