mark-parc/edge-carrier-rev-b/Compute Module PCB.pdf

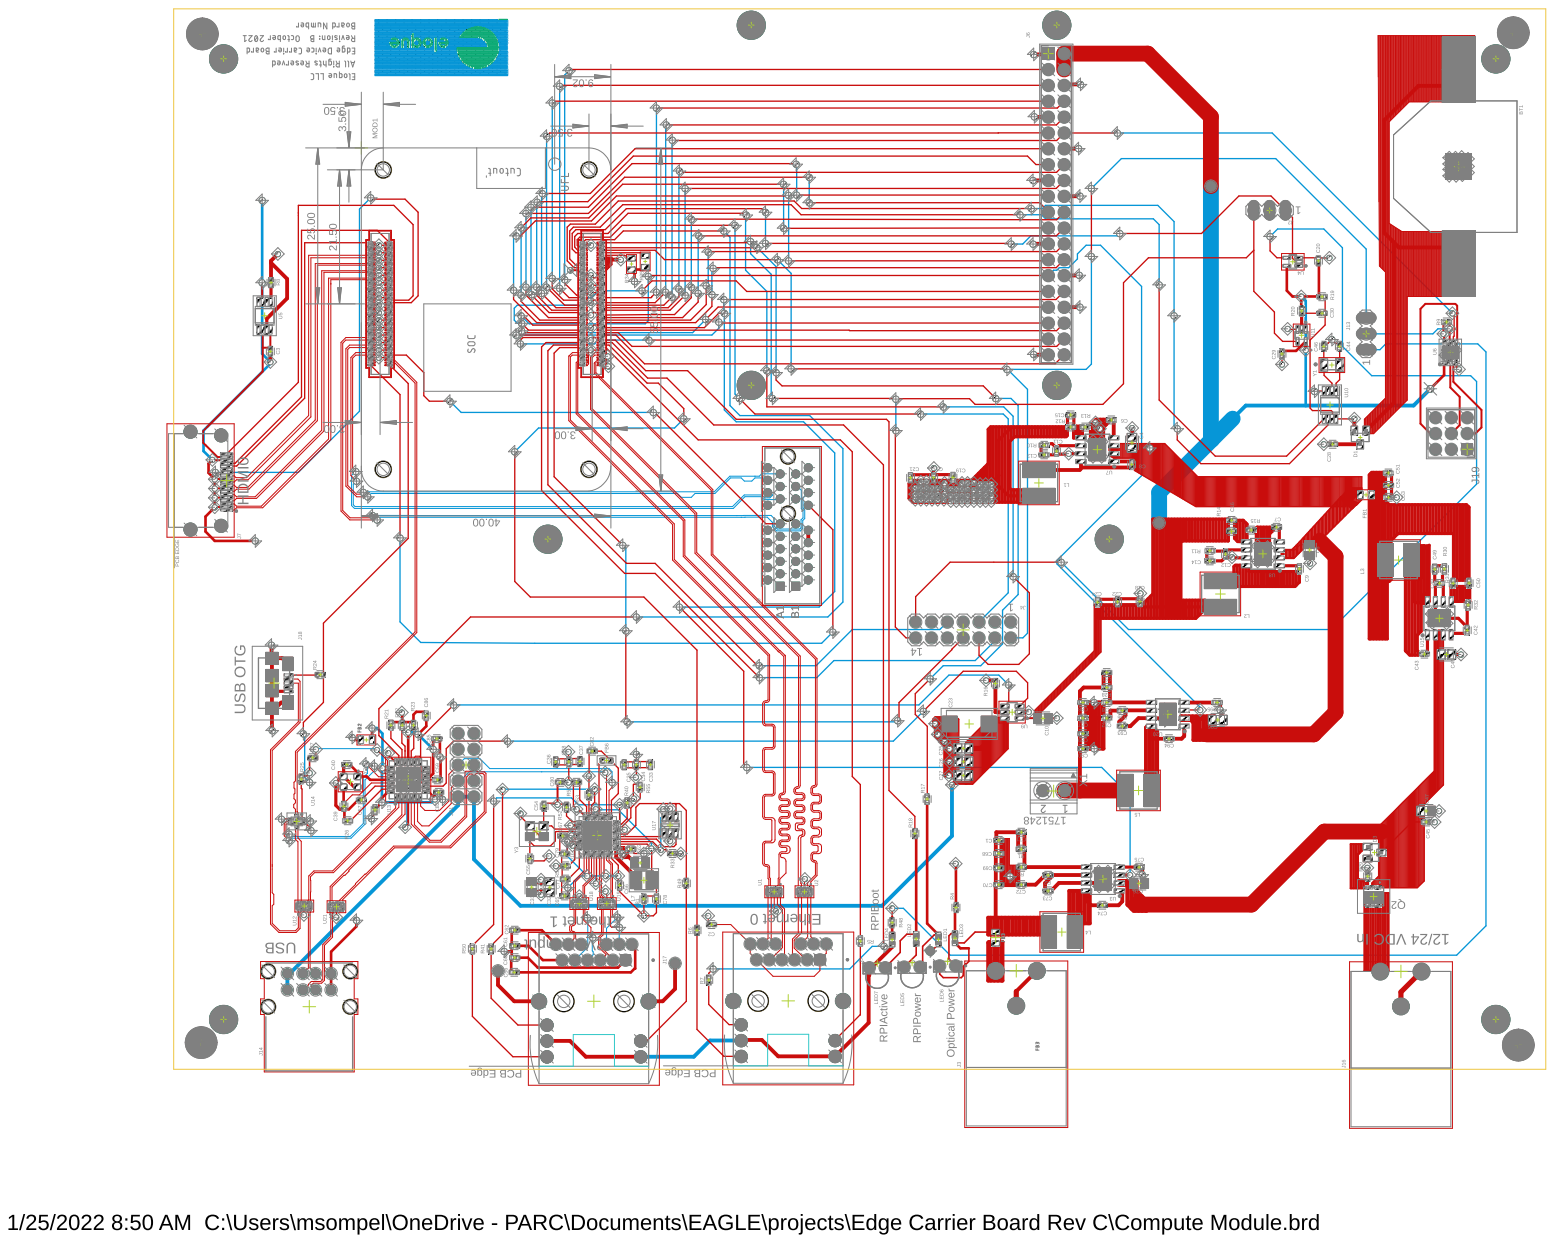
[picture p15: page 1]
