mark-parc/edge-carrier-rev-b/Compute Module.pdf

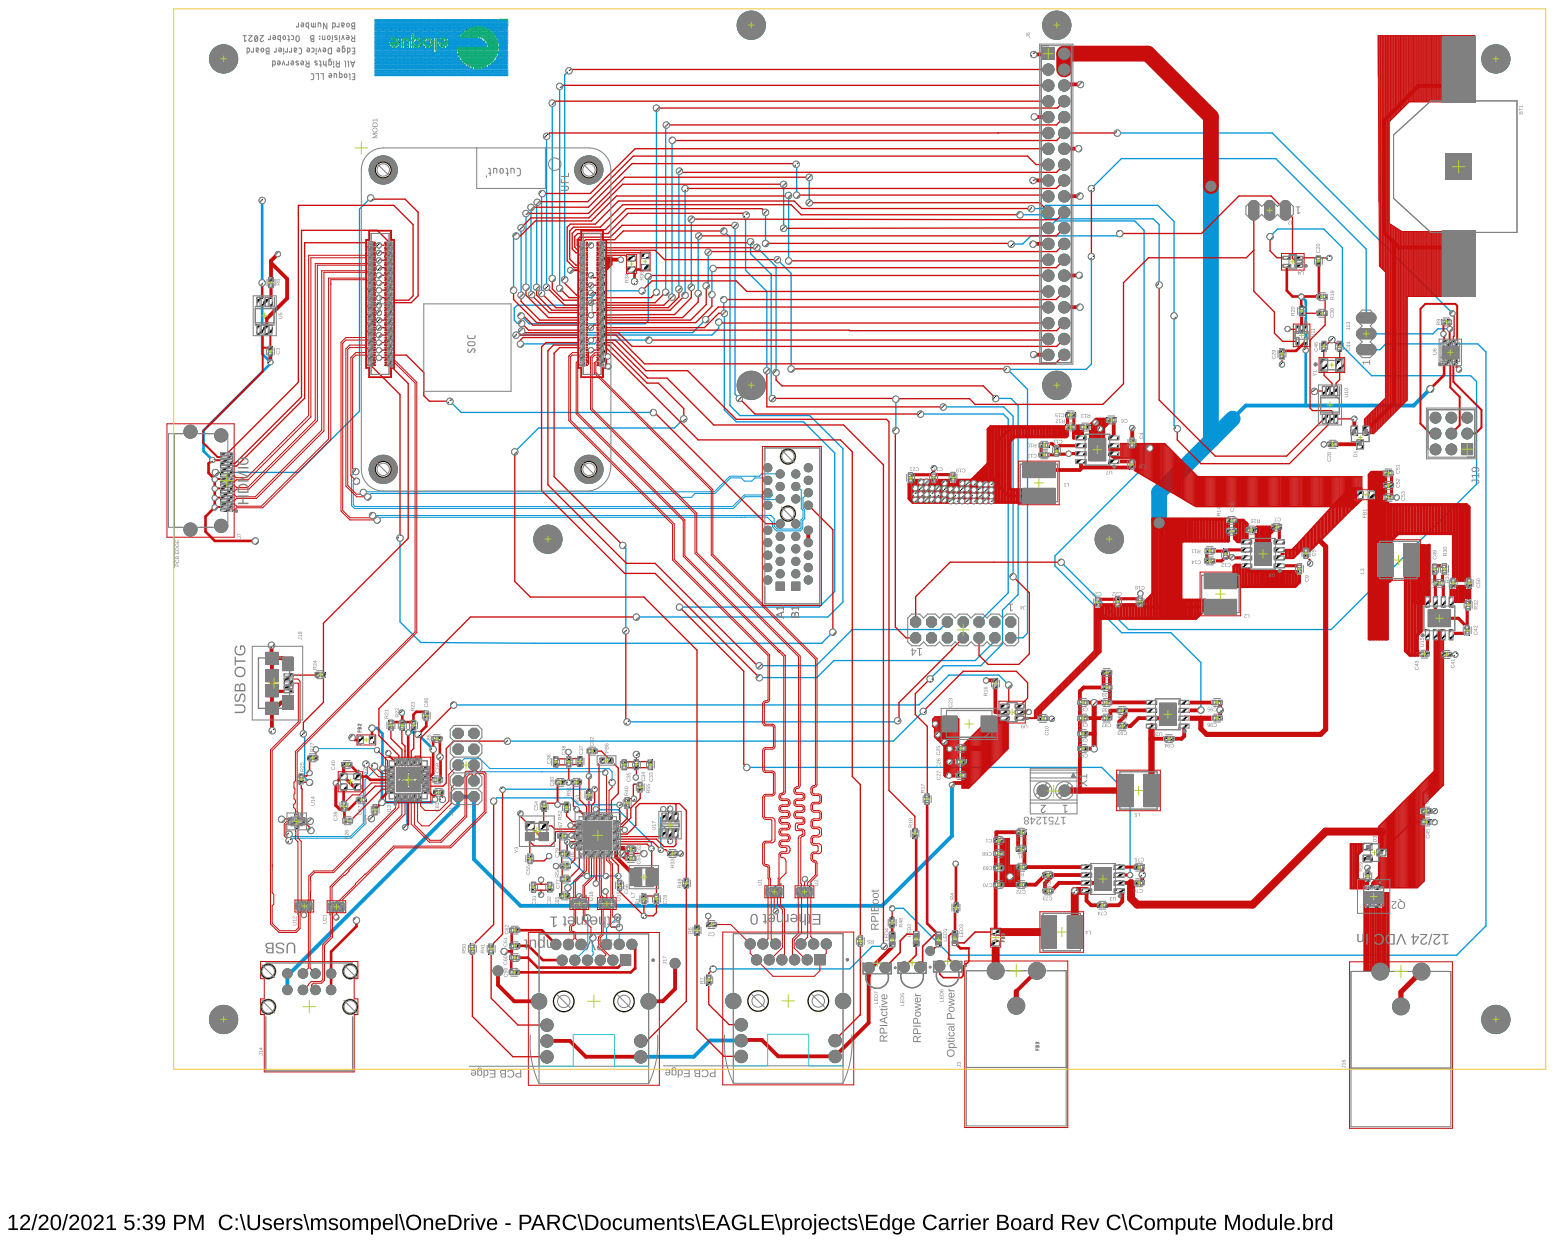
[picture p16: page 1]
