mark-parc/edge-carrier-rev-b/Compute Module.brd

## EAGLE design Compute Module.brd (2022-02-08)

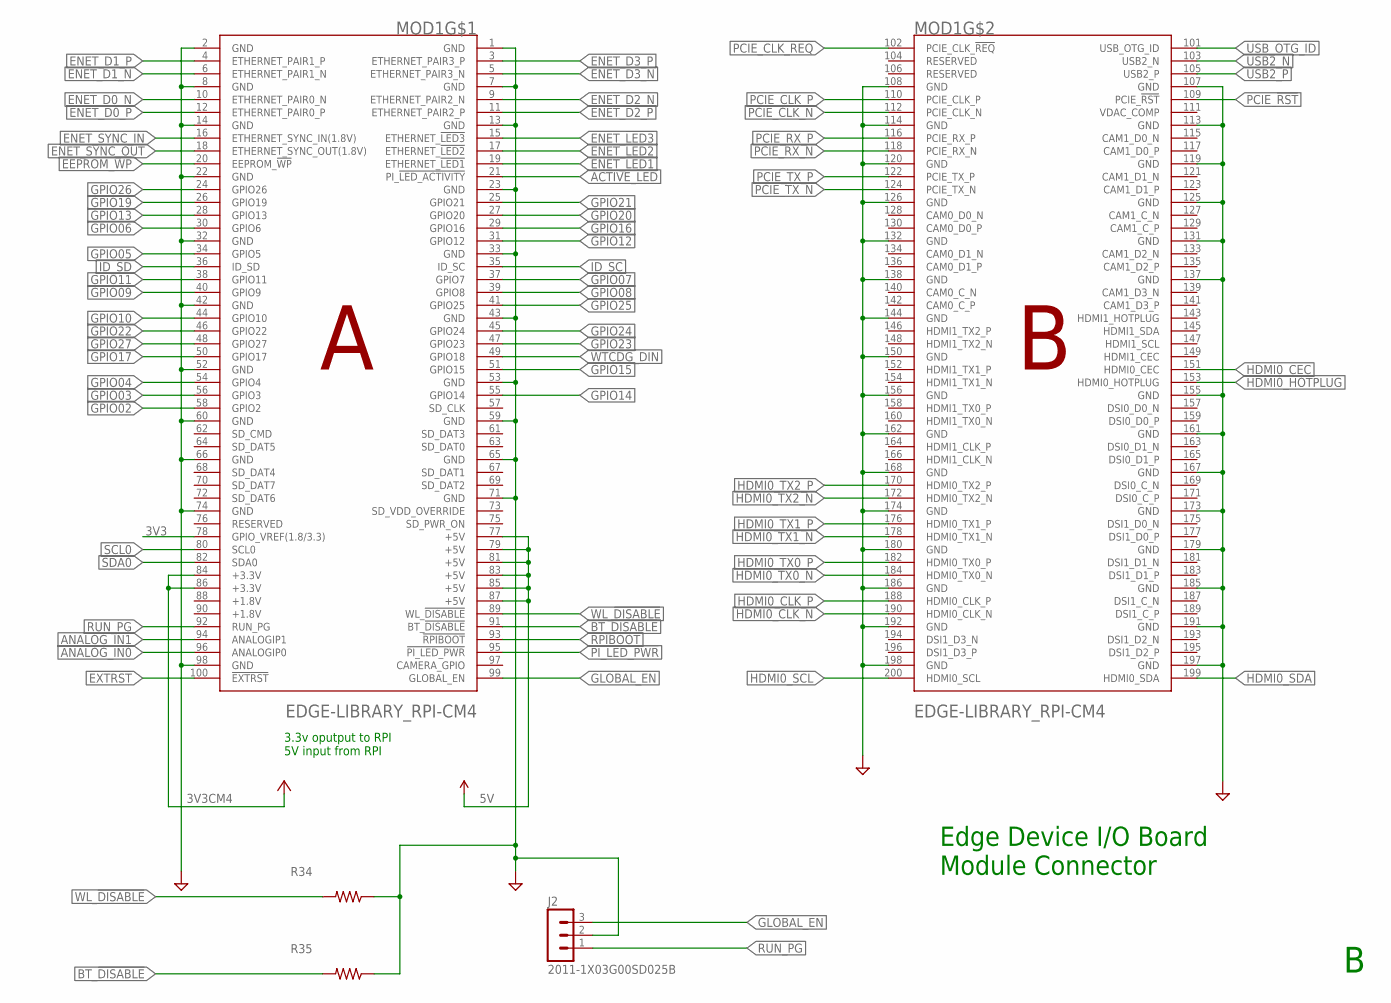
[picture p17: schematic Compute Module.sch, sheet 1]

Parts:
J2: 2011-1X03G00SD025B; CON-LSTB_MA03-1; MPN 2011-1X03G00SB; DIGIKEY 2553-2011-1X03G00SB-ND
MOD1: EDGE-LIBRARY_RPI-CM4
R34, R35: EDGE-LIBRARY_0805; MPN RC0805JR-070RL; DIGIKEY 311-0.0ARCT-ND

Connections:
3V3: MOD1.78 (GPIO_VREF(1.8/3.3)); also elsewhere on the board
3V3CM4: MOD1.84 (+3.3V), MOD1.86 (+3.3V)
5V: MOD1.77 (+5V), MOD1.79 (+5V), MOD1.81 (+5V), MOD1.83 (+5V), MOD1.85 (+5V), MOD1.87 (+5V); also elsewhere on the board
!EXTRST: MOD1.100 (!EXTRST); also elsewhere on the board
!PI_LED_PWR: MOD1.95 (!PI_LED_PWR); also elsewhere on the board
!RPIBOOT: MOD1.93 (!RPIBOOT); also elsewhere on the board
ACTIVE_!LED: MOD1.21 (PI_!LED_ACTIVITY); also elsewhere on the board
ANALOG_IN0: MOD1.96 (ANALOGIP0); also elsewhere on the board
ANALOG_IN1: MOD1.94 (ANALOGIP1); also elsewhere on the board
BT_!DISABLE: MOD1.91 (BT_!DISABLE), R35.2
EEPROM_!WP: MOD1.20 (EEPROM_!WP); also elsewhere on the board
ENET_!LED1: MOD1.19 (ETHERNET_!LED1); also elsewhere on the board
ENET_!LED2: MOD1.17 (ETHERNET_!LED2); also elsewhere on the board
ENET_!LED3: MOD1.15 (ETHERNET_!LED3); also elsewhere on the board
ENET_D0_N: MOD1.10 (ETHERNET_PAIR0_N); also elsewhere on the board
ENET_D0_P: MOD1.12 (ETHERNET_PAIR0_P); also elsewhere on the board
ENET_D1_N: MOD1.6 (ETHERNET_PAIR1_N); also elsewhere on the board
ENET_D1_P: MOD1.4 (ETHERNET_PAIR1_P); also elsewhere on the board
ENET_D2_N: MOD1.9 (ETHERNET_PAIR2_N); also elsewhere on the board
ENET_D2_P: MOD1.11 (ETHERNET_PAIR2_P); also elsewhere on the board
ENET_D3_N: MOD1.5 (ETHERNET_PAIR3_N); also elsewhere on the board
ENET_D3_P: MOD1.3 (ETHERNET_PAIR3_P); also elsewhere on the board
ENET_SYNC_IN: MOD1.16 (ETHERNET_SYNC_IN(1.8V)); also elsewhere on the board
ENET_SYNC_OUT: MOD1.18 (ETHERNET_SYNC_OUT(1.8V)); also elsewhere on the board
GLOBAL_EN: J2.3, MOD1.99 (GLOBAL_EN); also elsewhere on the board
GND: J2.2, MOD1.1 (GND), MOD1.2 (GND), MOD1.7 (GND), MOD1.8 (GND), MOD1.13 (GND), MOD1.14 (GND), MOD1.22 (GND), MOD1.23 (GND), MOD1.32 (GND), MOD1.33 (GND), MOD1.42 (GND), MOD1.43 (GND), MOD1.52 (GND), MOD1.53 (GND), MOD1.59 (GND), MOD1.60 (GND), MOD1.65 (GND), MOD1.66 (GND), MOD1.71 (GND), MOD1.74 (GND), MOD1.98 (GND), MOD1.107 (GND), MOD1.108 (GND), MOD1.113 (GND), MOD1.114 (GND), MOD1.119 (GND), MOD1.120 (GND), MOD1.125 (GND), MOD1.126 (GND), MOD1.131 (GND), MOD1.132 (GND), MOD1.137 (GND), MOD1.138 (GND), MOD1.144 (GND), MOD1.150 (GND), MOD1.155 (GND), MOD1.156 (GND), MOD1.161 (GND), MOD1.162 (GND), MOD1.167 (GND), MOD1.168 (GND), MOD1.173 (GND), MOD1.174 (GND), MOD1.179 (GND), MOD1.180 (GND), MOD1.185 (GND), MOD1.186 (GND), MOD1.191 (GND), MOD1.192 (GND), MOD1.197 (GND), MOD1.198 (GND), R34.1, R35.1; also elsewhere on the board
GPIO02: MOD1.58 (GPIO2); also elsewhere on the board
GPIO03: MOD1.56 (GPIO3); also elsewhere on the board
GPIO04: MOD1.54 (GPIO4); also elsewhere on the board
GPIO05: MOD1.34 (GPIO5); also elsewhere on the board
GPIO06: MOD1.30 (GPIO6); also elsewhere on the board
GPIO07: MOD1.37 (GPIO7); also elsewhere on the board
GPIO08: MOD1.39 (GPIO8); also elsewhere on the board
GPIO09: MOD1.40 (GPIO9); also elsewhere on the board
GPIO10: MOD1.44 (GPIO10); also elsewhere on the board
GPIO11: MOD1.38 (GPIO11); also elsewhere on the board
GPIO12: MOD1.31 (GPIO12); also elsewhere on the board
GPIO13: MOD1.28 (GPIO13); also elsewhere on the board
GPIO14: MOD1.55 (GPIO14); also elsewhere on the board
GPIO15: MOD1.51 (GPIO15); also elsewhere on the board
GPIO16: MOD1.29 (GPIO16); also elsewhere on the board
GPIO17: MOD1.50 (GPIO17); also elsewhere on the board
GPIO19: MOD1.26 (GPIO19); also elsewhere on the board
GPIO20: MOD1.27 (GPIO20); also elsewhere on the board
GPIO21: MOD1.25 (GPIO21); also elsewhere on the board
GPIO22: MOD1.46 (GPIO22); also elsewhere on the board
GPIO23: MOD1.47 (GPIO23); also elsewhere on the board
GPIO24: MOD1.45 (GPIO24); also elsewhere on the board
GPIO25: MOD1.41 (GPIO25); also elsewhere on the board
GPIO26: MOD1.24 (GPIO26); also elsewhere on the board
GPIO27: MOD1.48 (GPIO27); also elsewhere on the board
HDMI0_CEC: MOD1.151 (HDMI0_CEC); also elsewhere on the board
HDMI0_CLK_N: MOD1.190 (HDMI0_CLK_N); also elsewhere on the board
HDMI0_CLK_P: MOD1.188 (HDMI0_CLK_P); also elsewhere on the board
HDMI0_HOTPLUG: MOD1.153 (HDMI0_HOTPLUG); also elsewhere on the board
HDMI0_SCL: MOD1.200 (HDMI0_SCL); also elsewhere on the board
HDMI0_SDA: MOD1.199 (HDMI0_SDA); also elsewhere on the board
HDMI0_TX0_N: MOD1.184 (HDMI0_TX0_N); also elsewhere on the board
HDMI0_TX0_P: MOD1.182 (HDMI0_TX0_P); also elsewhere on the board
HDMI0_TX1_N: MOD1.178 (HDMI0_TX1_N); also elsewhere on the board
HDMI0_TX1_P: MOD1.176 (HDMI0_TX1_P); also elsewhere on the board
HDMI0_TX2_N: MOD1.172 (HDMI0_TX2_N); also elsewhere on the board
HDMI0_TX2_P: MOD1.170 (HDMI0_TX2_P); also elsewhere on the board
ID_SC: MOD1.35 (ID_SC); also elsewhere on the board
ID_SD: MOD1.36 (ID_SD); also elsewhere on the board
PCIE_!RST: MOD1.109 (PCIE_!RST); also elsewhere on the board
PCIE_CLK_!REQ: MOD1.102 (PCIE_CLK_!REQ); also elsewhere on the board
PCIE_CLK_N: MOD1.112 (PCIE_CLK_N); also elsewhere on the board
PCIE_CLK_P: MOD1.110 (PCIE_CLK_P); also elsewhere on the board
PCIE_RX_N: MOD1.118 (PCIE_RX_N); also elsewhere on the board
PCIE_RX_P: MOD1.116 (PCIE_RX_P); also elsewhere on the board
PCIE_TX_N: MOD1.124 (PCIE_TX_N); also elsewhere on the board
PCIE_TX_P: MOD1.122 (PCIE_TX_P); also elsewhere on the board
RUN_PG: J2.1, MOD1.92 (RUN_PG); also elsewhere on the board
SCL0: MOD1.80 (SCL0); also elsewhere on the board
SDA0: MOD1.82 (SDA0); also elsewhere on the board
USB2_N: MOD1.103 (USB2_N); also elsewhere on the board
USB2_P: MOD1.105 (USB2_P); also elsewhere on the board
USB_OTG_ID: MOD1.101 (USB_OTG_ID); also elsewhere on the board
WL_!DISABLE: MOD1.89 (WL_!DISABLE), R34.2
WTCDG_DIN: MOD1.49 (GPIO18); also elsewhere on the board

Notes on the sheet:
Edge Device I/O Board Module Connector
3.3v oputput to RPI 5V input from RPI

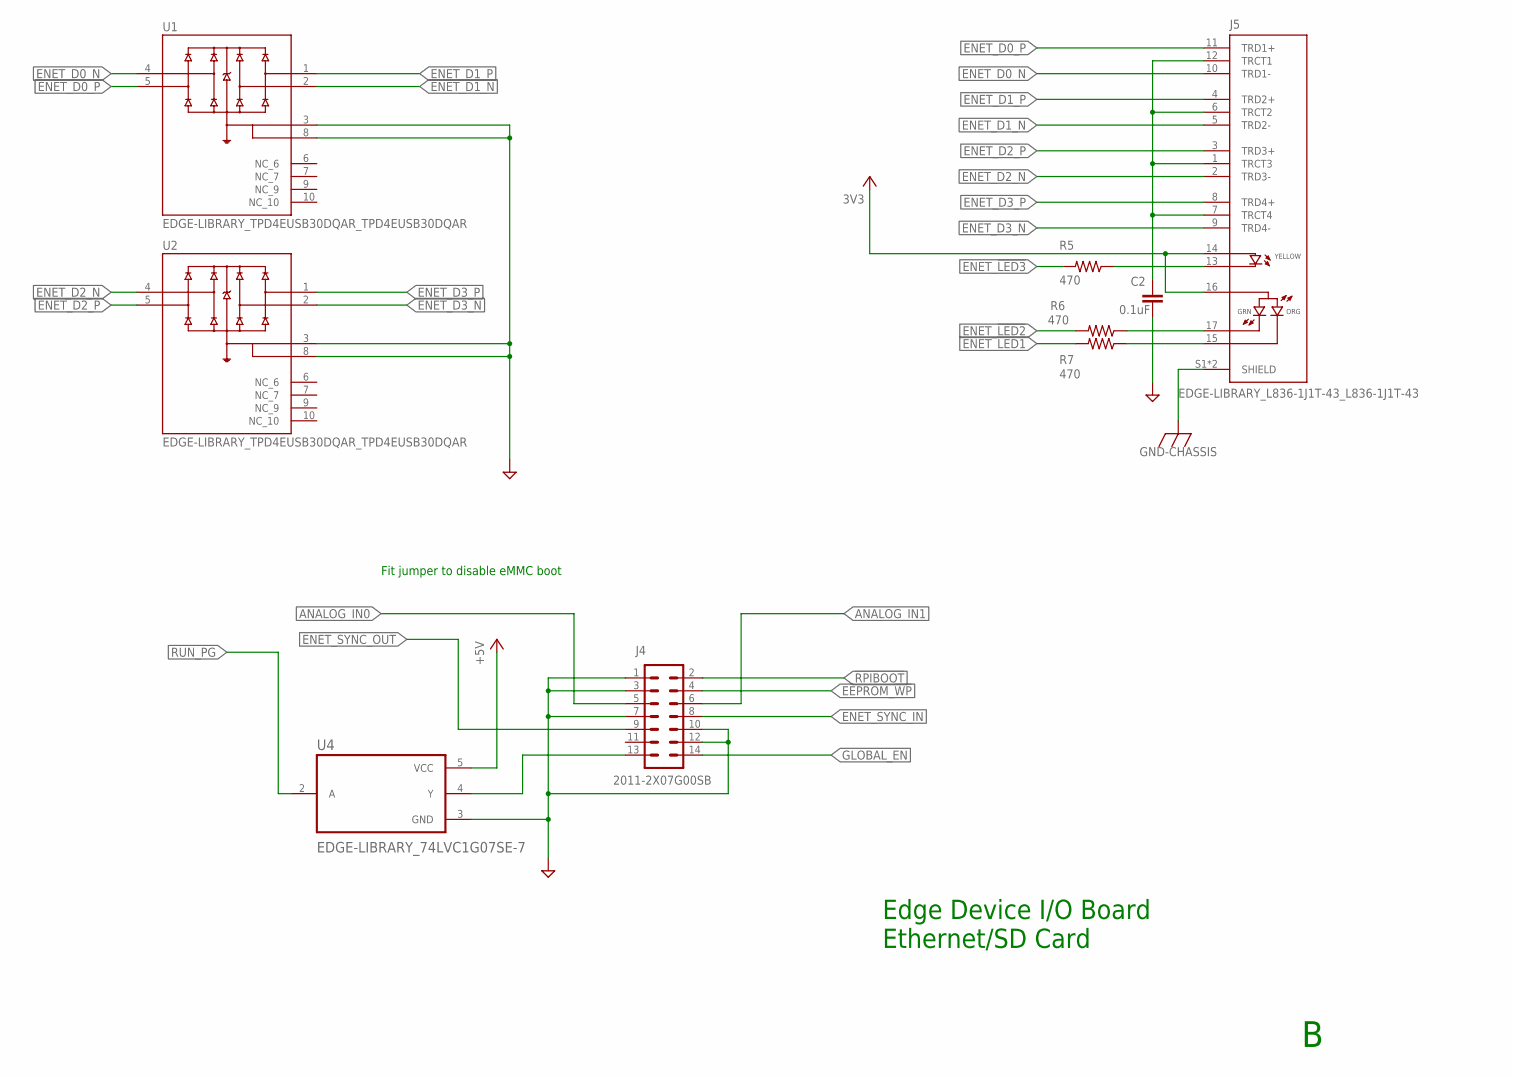
[picture p18: schematic Compute Module.sch, sheet 2]

Parts:
C2: 0.1uF; EDGE-LIBRARY_TUTORIAL---FUSION-360_CAPC1005X60; MPN C0402C104K4RACTU; DIGIKEY 399-3521-1-ND
J4: 2011-2X07G00SB; CON-LSTB_MA07-2; MPN 2011-2X07G00SB; DIGIKEY 2553-2011-2X07G00SB-ND
J5: EDGE-LIBRARY_L836-1J1T-43_L836-1J1T-43; EDGE-LIBRARY_L836-1J1T-43_BEL_L836-1J1T-43
R5, R6, R7: 470; EDGE-LIBRARY_TUTORIAL---FUSION-360_RESC1005X40; MPN RC0402FR-07470RL; DIGIKEY 311-470LRCT-ND
U1, U2: EDGE-LIBRARY_TPD4EUSB30DQAR_TPD4EUSB30DQAR; EDGE-LIBRARY_TPD4EUSB30DQAR_IC_TPD4EUSB30DQAR
U4: EDGE-LIBRARY_74LVC1G07SE-7; EDGE-LIBRARY_SOT65P210X110-5N

Connections:
3V3: J5.14, J5.16; also elsewhere on the board
5V: U4.5 (VCC); also elsewhere on the board
!RPIBOOT: J4.2; also elsewhere on the board
ANALOG_IN0: J4.5; also elsewhere on the board
ANALOG_IN1: J4.6; also elsewhere on the board
CGND: J5.S1 (SHIELD), J5.S2 (SHIELD); also elsewhere on the board
EEPROM_!WP: J4.4; also elsewhere on the board
ENET_!LED1: R7.2; also elsewhere on the board
ENET_!LED2: R6.2; also elsewhere on the board
ENET_!LED3: R5.2; also elsewhere on the board
ENET_D0_N: J5.10 (TRD1-), U1.4 (D2+); also elsewhere on the board
ENET_D0_P: J5.11 (TRD1+), U1.5 (D2-); also elsewhere on the board
ENET_D1_N: J5.5 (TRD2-), U1.2 (D1-); also elsewhere on the board
ENET_D1_P: J5.4 (TRD2+), U1.1 (D1+); also elsewhere on the board
ENET_D2_N: J5.2 (TRD3-), U2.4 (D2+); also elsewhere on the board
ENET_D2_P: J5.3 (TRD3+), U2.5 (D2-); also elsewhere on the board
ENET_D3_N: J5.9 (TRD4-), U2.2 (D1-); also elsewhere on the board
ENET_D3_P: J5.8 (TRD4+), U2.1 (D1+); also elsewhere on the board
ENET_SYNC_IN: J4.8; also elsewhere on the board
ENET_SYNC_OUT: J4.9; also elsewhere on the board
GLOBAL_EN: J4.14; also elsewhere on the board
GND: C2.2, J4.1, J4.3, J4.7, J4.10, J4.12, U1.3 (GND_3), U1.8 (GND_8), U2.3 (GND_3), U2.8 (GND_8), U4.3 (GND); also elsewhere on the board
unnamed: C2.1, J5.1 (TRCT3), J5.6 (TRCT2), J5.7 (TRCT4), J5.12 (TRCT1)
unnamed: J5.13, R5.1
unnamed: J5.17, R6.1
unnamed: J5.15, R7.1
unnamed: J4.13, U4.4 (Y)
RUN_PG: U4.2 (A); also elsewhere on the board

Notes on the sheet:
Edge Device I/O Board Ethernet/SD Card
Fit jumper to disable eMMC boot

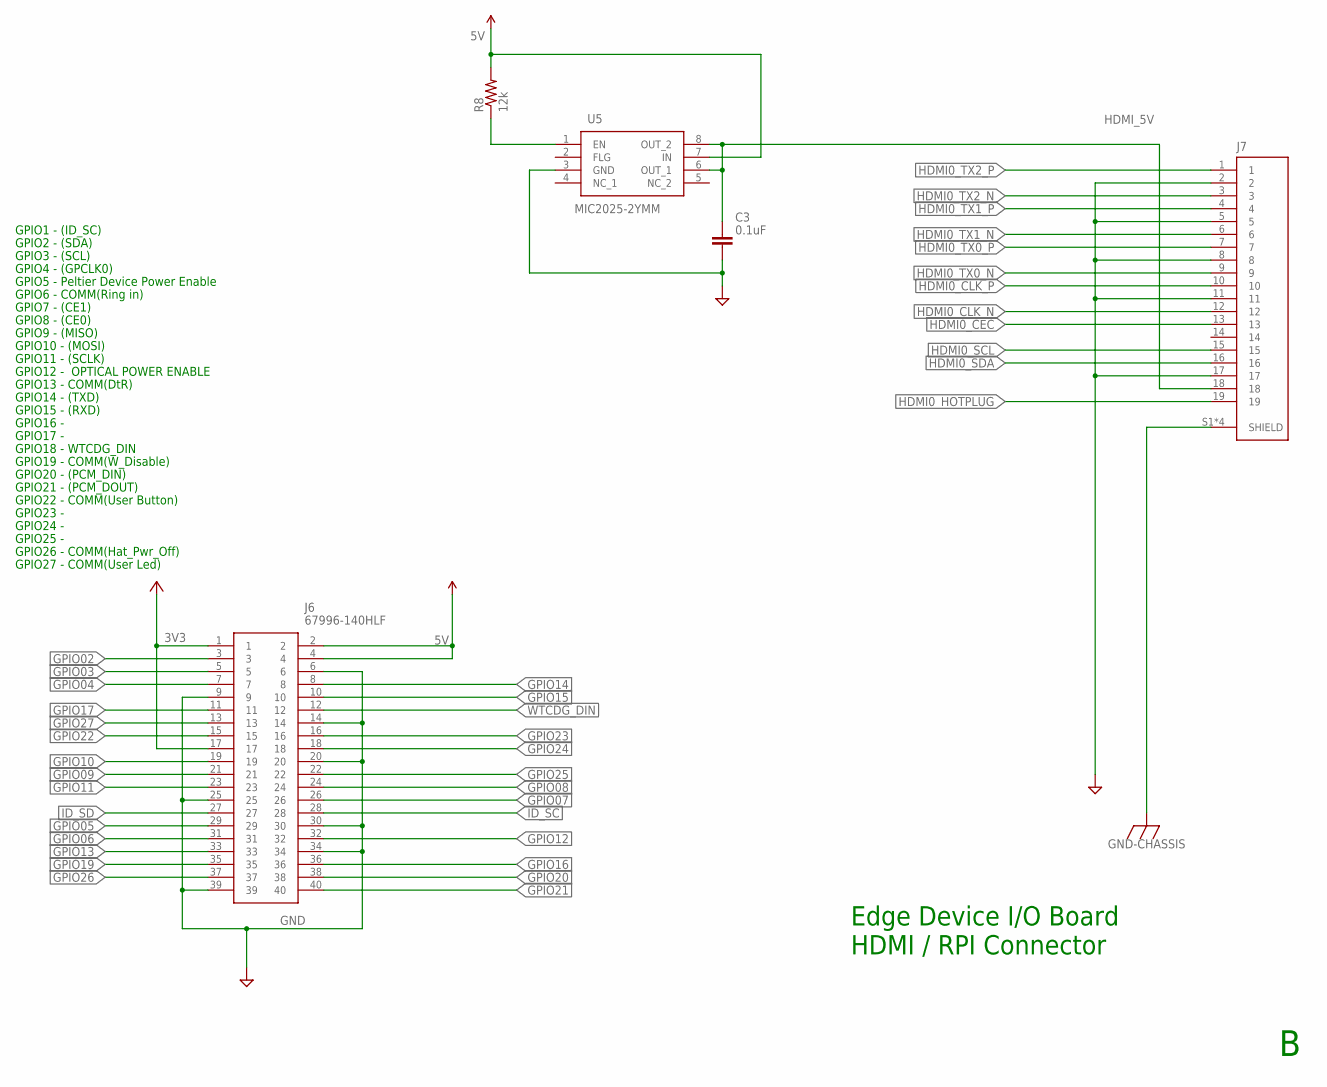
[picture p19: schematic Compute Module.sch, sheet 3]

Parts:
C3: 0.1uF; EDGE-LIBRARY_TUTORIAL---FUSION-360_CAPC1005X60; MPN C0402C104K4RACTU; DIGIKEY 399-3521-1-ND
J6: 67996-140HLF; HDRV40W67P254_2X20_5080X483X85
J7: EDGE-LIBRARY_HDMI_CONNECTOR_RT_SMA; EDGE-LIBRARY_STEWART_SS-53000-001
R8: 12k; EDGE-LIBRARY_TUTORIAL---FUSION-360_RESC1005X40; MPN RC0402FR-0712KL; DIGIKEY 311-12.0KLRCT-ND
U5: MIC2025-2YMM; SOP65P490X110-8N

Connections:
3V3: J6.1, J6.17; also elsewhere on the board
5V: J6.2, J6.4, R8.2, U5.7 (IN); also elsewhere on the board
CGND: J7.S1 (SHIELD), J7.S2 (SHIELD), J7.S3 (SHIELD), J7.S4 (SHIELD); also elsewhere on the board
GND: C3.2, J6.6, J6.9, J6.14, J6.20, J6.25, J6.30, J6.34, J6.39, J7.2, J7.5, J7.8, J7.11, J7.17, U5.3 (GND); also elsewhere on the board
GPIO02: J6.3; also elsewhere on the board
GPIO03: J6.5; also elsewhere on the board
GPIO04: J6.7; also elsewhere on the board
GPIO05: J6.29; also elsewhere on the board
GPIO06: J6.31; also elsewhere on the board
GPIO07: J6.26; also elsewhere on the board
GPIO08: J6.24; also elsewhere on the board
GPIO09: J6.21; also elsewhere on the board
GPIO10: J6.19; also elsewhere on the board
GPIO11: J6.23; also elsewhere on the board
GPIO12: J6.32; also elsewhere on the board
GPIO13: J6.33; also elsewhere on the board
GPIO14: J6.8; also elsewhere on the board
GPIO15: J6.10; also elsewhere on the board
GPIO16: J6.36; also elsewhere on the board
GPIO17: J6.11; also elsewhere on the board
GPIO19: J6.35; also elsewhere on the board
GPIO20: J6.38; also elsewhere on the board
GPIO21: J6.40; also elsewhere on the board
GPIO22: J6.15; also elsewhere on the board
GPIO23: J6.16; also elsewhere on the board
GPIO24: J6.18; also elsewhere on the board
GPIO25: J6.22; also elsewhere on the board
GPIO26: J6.37; also elsewhere on the board
GPIO27: J6.13; also elsewhere on the board
HDMI0_CEC: J7.13; also elsewhere on the board
HDMI0_CLK_N: J7.12; also elsewhere on the board
HDMI0_CLK_P: J7.10; also elsewhere on the board
HDMI0_HOTPLUG: J7.19; also elsewhere on the board
HDMI0_SCL: J7.15; also elsewhere on the board
HDMI0_SDA: J7.16; also elsewhere on the board
HDMI0_TX0_N: J7.9; also elsewhere on the board
HDMI0_TX0_P: J7.7; also elsewhere on the board
HDMI0_TX1_N: J7.6; also elsewhere on the board
HDMI0_TX1_P: J7.4; also elsewhere on the board
HDMI0_TX2_N: J7.3; also elsewhere on the board
HDMI0_TX2_P: J7.1; also elsewhere on the board
HDMI_5V: C3.1, J7.18, U5.6 (OUT_1), U5.8 (OUT_2)
ID_SC: J6.28; also elsewhere on the board
ID_SD: J6.27; also elsewhere on the board
unnamed: R8.1, U5.1 (EN)
WTCDG_DIN: J6.12; also elsewhere on the board

Notes on the sheet:
Edge Device I/O Board HDMI / RPI Connector
GPIO18 - WTCDG_DIN
GPIO27 - COMM(User Led)
GPIO22 - COMM(User Button)
GPIO6 - COMM(Ring in)
GPIO13 - COMM(DtR)
GPIO19 - COMM(W_Disable)
GPIO26 - COMM(Hat_Pwr_Off)
GPIO1 - (ID_SC)
GPIO2 - (SDA)
GPIO3 - (SCL)
GPIO4 - (GPCLK0)
GPIO5 - Peltier Device Power Enable
GPIO7 - (CE1)
GPIO8 - (CE0)
GPIO9 - (MISO)
GPIO10 - (MOSI)
GPIO11 - (SCLK)
GPIO12 - OPTICAL POWER ENABLE
GPIO14 - (TXD)
GPIO15 - (RXD)
GPIO16 -
GPIO17 -
GPIO20 - (PCM_DIN)
GPIO21 - (PCM_DOUT)
GPIO23 -
GPIO24 -
GPIO25 -

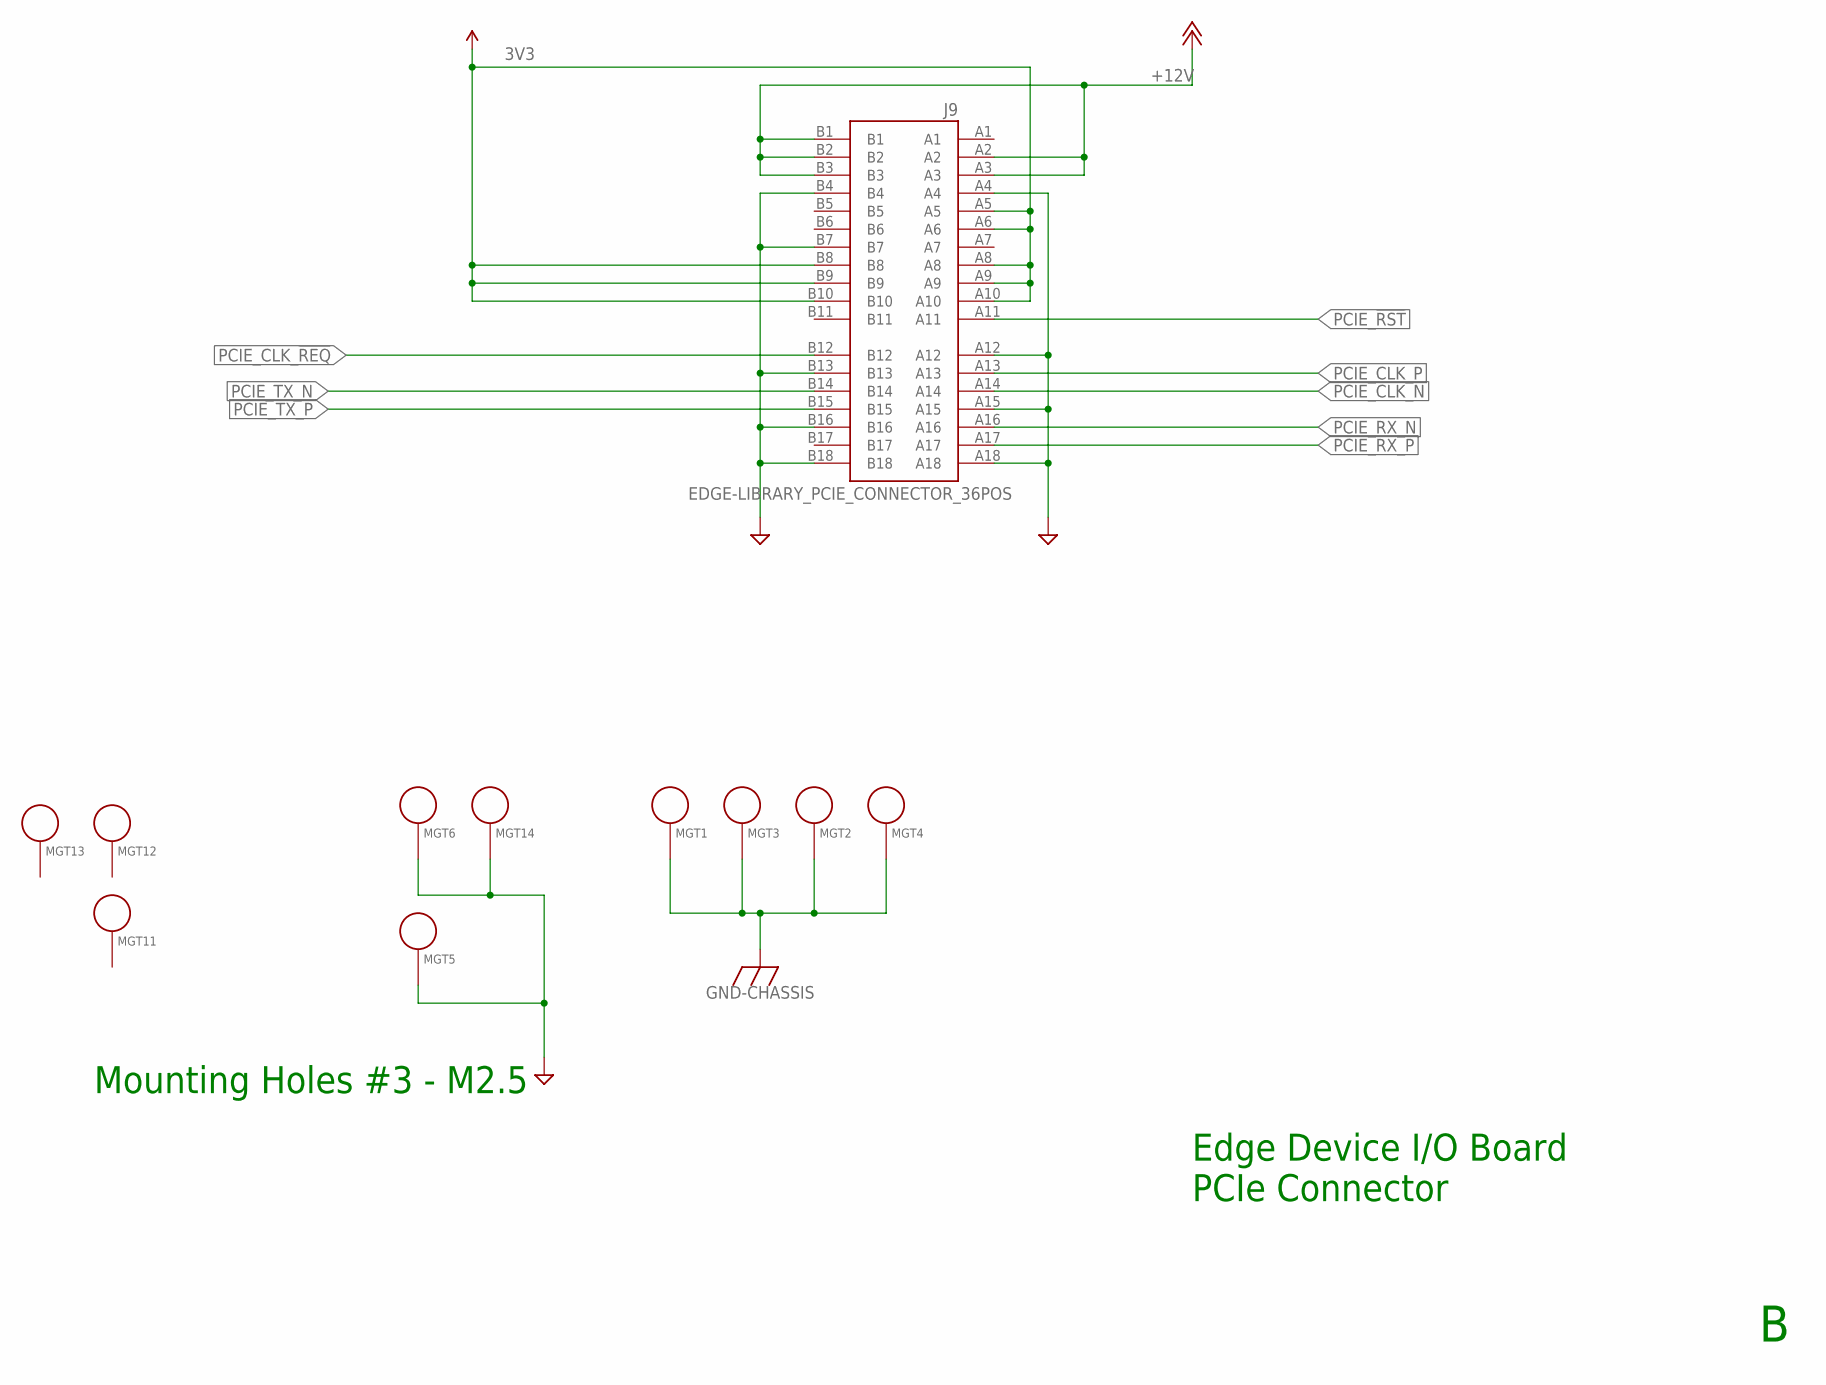
[picture p20: schematic Compute Module.sch, sheet 4]

Parts:
J9: EDGE-LIBRARY_PCIE_CONNECTOR_36POS; EDGE-LIBRARY_AMPHENOL_10018784-10210TLF
MGT1, MGT2, MGT3, MGT4, MGT5, MGT6, MGT14: MOUNTING_HOLE; BEAGLEBONEBLACK_MOUNTING_HOLE; DIGIKEY DNP
MGT11, MGT12, MGT13: MOUNTING_HOLE; BEAGLEBONEBLACK_MOUNTING_HOLE

Connections:
3V3: J9.A5, J9.A6, J9.A8, J9.A9, J9.A10, J9.B8, J9.B9, J9.B10; also elsewhere on the board
+12V: J9.A2, J9.A3, J9.B1, J9.B2, J9.B3; also elsewhere on the board
CGND: MGT1.P$1, MGT2.P$1, MGT3.P$1, MGT4.P$1; also elsewhere on the board
GND: J9.A4, J9.A12, J9.A15, J9.A18, J9.B4, J9.B7, J9.B13, J9.B16, J9.B18, MGT5.P$1, MGT6.P$1, MGT14.P$1; also elsewhere on the board
PCIE_!RST: J9.A11; also elsewhere on the board
PCIE_CLK_!REQ: J9.B12; also elsewhere on the board
PCIE_CLK_N: J9.A14; also elsewhere on the board
PCIE_CLK_P: J9.A13; also elsewhere on the board
PCIE_RX_N: J9.A16; also elsewhere on the board
PCIE_RX_P: J9.A17; also elsewhere on the board
PCIE_TX_N: J9.B14; also elsewhere on the board
PCIE_TX_P: J9.B15; also elsewhere on the board

Notes on the sheet:
Edge Device I/O Board PCIe Connector
Mounting Holes #3 - M2.5

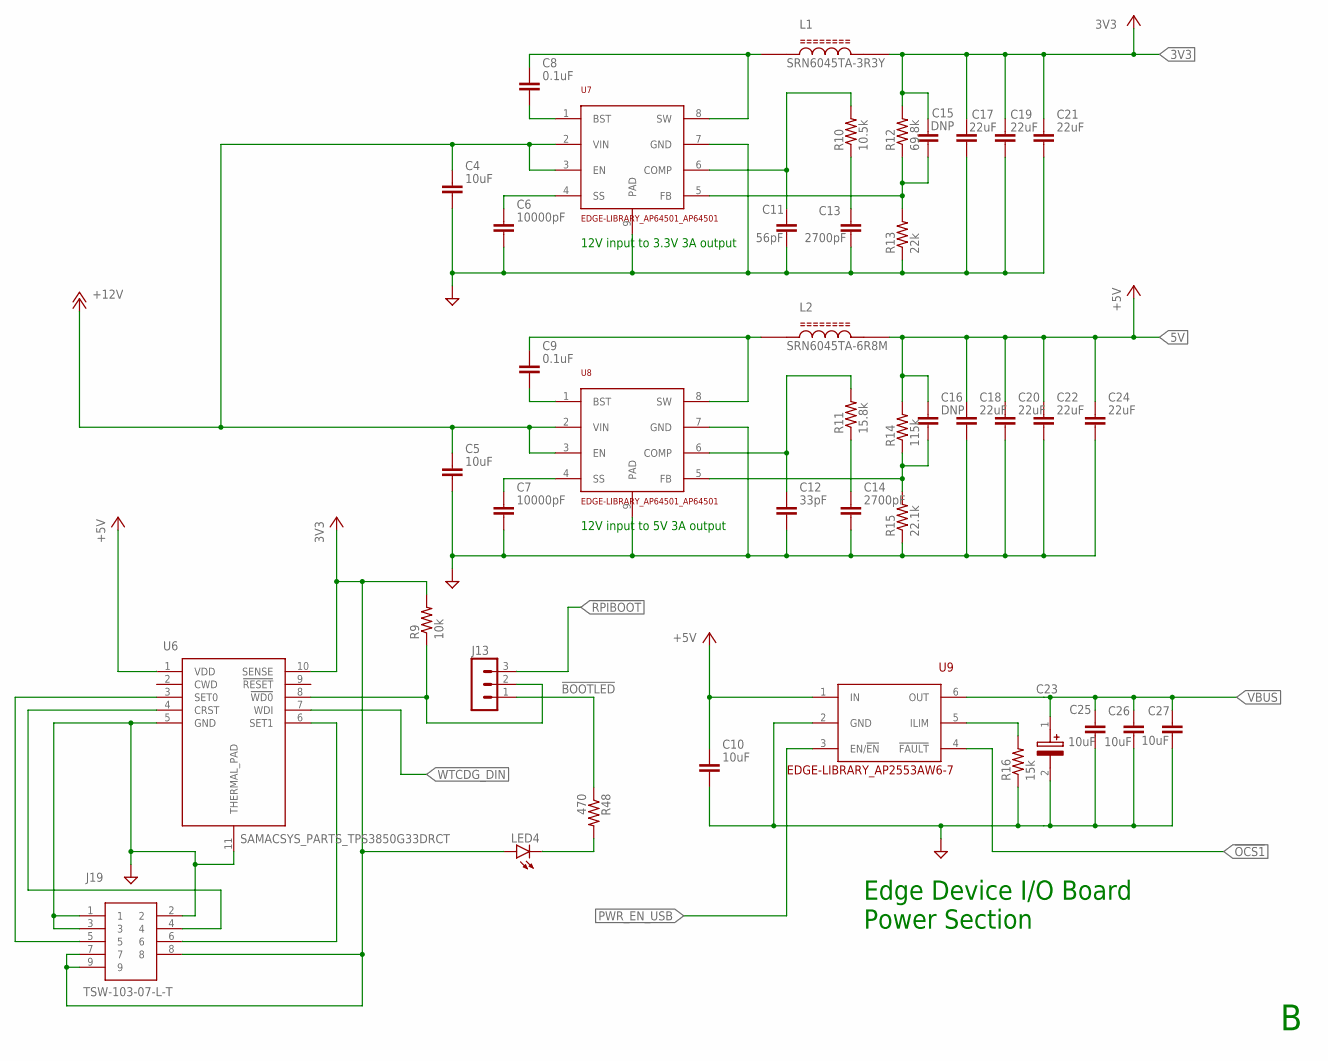
[picture p21: schematic Compute Module.sch, sheet 5]

Parts:
C4, C5, C10, C25, C26, C27: 10uF; EDGE-LIBRARY_TUTORIAL---FUSION-360_CAPC2012X110; MPN GRM21BR71A106KA73K; DIGIKEY 490-14381-1-ND
C6, C7: 10000pF; EDGE-LIBRARY_TUTORIAL---FUSION-360_CAPC1005X60; MPN CM02X5R103M16AH; DIGIKEY 1253-CM02X5R103M16AHCT-ND
C8, C9: 0.1uF; EDGE-LIBRARY_TUTORIAL---FUSION-360_CAPC1005X60; MPN C0402C104K4RACTU; DIGIKEY 399-3521-1-ND
C11: 56pF; EDGE-LIBRARY_TUTORIAL---FUSION-360_CAPC1005X60; MPN EMK042CG560JC-W; DIGIKEY 587-6134-1-ND
C12: 33pF; EDGE-LIBRARY_TUTORIAL---FUSION-360_CAPC1005X60; MPN GMC04CG330J16NT; DIGIKEY 2571-GMC04CG330J16NTTR-ND
C13, C14: 2700pF; EDGE-LIBRARY_TUTORIAL---FUSION-360_CAPC1005X60; MPN GMC04X5R272M50NT; DIGIKEY 2571-GMC04X5R272M50NTTR-ND
C15, C16: DNP; EDGE-LIBRARY_TUTORIAL---FUSION-360_CAPC1005X60
C17, C18, C19, C20, C21, C22, C24: 22uF; EDGE-LIBRARY_TUTORIAL---FUSION-360_CAPC1005X60; MPN GMC04X5R226M6R3NT; DIGIKEY 2571-GMC04X5R226M6R3NTTR-ND
C23: 100uF; CAPPM7343X200N
J13: 2553-2011-1X03G00SB-ND; CON-LSTB_MA03-1; MPN 2011-1X03G00SB; DIGIKEY 2553-2011-1X03G00SB-ND
J19: TSW-103-07-L-T; HDRV9W64P254_3X3_762X749X838P
L1: EDGE-LIBRARY_SRN6045TA-3R3Y_SRN6045TA-3R3Y; EDGE-LIBRARY_SRN6045TA-3R3Y_IND_SRN6045TA-3R3Y
L2: EDGE-LIBRARY_SRN6045TA-3R3Y_SRN6045TA-3R3Y; EDGE-LIBRARY_SRN6045TA-3R3Y_IND_SRN6045TA-3R3Y; MPN SRN6045TA-6R8M; DIGIKEY SRN6045TA-6R8MCT-ND
LED4: LTST-S270KGKT; LED_CHIP-LED0603; MPN LTST-S270KGKT; DIGIKEY LTST-S270KGKT
R9: 10k; EDGE-LIBRARY_TUTORIAL---FUSION-360_RESC1005X40; MPN RM04J103CT; DIGIKEY 2571-RM04J103CTTR-ND
R10: 10.5k; EDGE-LIBRARY_TUTORIAL---FUSION-360_RESC1005X40; MPN RC0402FR-0710K5L; DIGIKEY YAG2951CT-ND
R11: 15.8k; EDGE-LIBRARY_TUTORIAL---FUSION-360_RESC1005X40; MPN CRCW040215K8FKED; DIGIKEY 541-15.8KLCT-ND
R12: 69.8k; EDGE-LIBRARY_TUTORIAL---FUSION-360_RESC1005X40; MPN RMCF0402FT69K8; DIGIKEY RMCF0402FT69K8CT-ND
R13: 22k; EDGE-LIBRARY_TUTORIAL---FUSION-360_RESC1005X40; MPN RM04J223CT; DIGIKEY 2571-RM04J222CTTR-ND
R14: 115k; EDGE-LIBRARY_TUTORIAL---FUSION-360_RESC1005X40; MPN RP73PF1E115KBTD; DIGIKEY A127517CT-ND
R15: 22.1k; EDGE-LIBRARY_TUTORIAL---FUSION-360_RESC1005X40; MPN RN04D2212CT10-25; DIGIKEY 2571-RN04D2212CT10-25TR-ND
R16: 15k; EDGE-LIBRARY_TUTORIAL---FUSION-360_RESC1005X40; MPN RMCF0402FT15K0; DIGIKEY RMCF0402FT15K0CT-ND
R48: 470; EDGE-LIBRARY_TUTORIAL---FUSION-360_RESC1005X40; MPN RC0402FR-07470RL; DIGIKEY 311-470LRCT-ND
U6: SAMACSYS_PARTS_TPS3850G33DRCT; SAMACSYS_PARTS_SON50P300X300X100-11N; DIGIKEY 2156-TPS3850G33DRCR-ND
U7, U8: EDGE-LIBRARY_AP64501_AP64501; EDGE-LIBRARY_AP64501_SOIC127P600X265-9T261X350N
U9: EDGE-LIBRARY_AP2553AW6-7; EDGE-LIBRARY_SOT95P280X140-6N; MPN AP22653AW6-7; DIGIKEY 31-AP22653AW6-7CT-ND

Connections:
3V3: C15.1, C17.1, C19.1, C21.1, J19.7, J19.8, J19.9, L1.2, LED4.A, R9.2, R12.2, U6.10 (SENSE); also elsewhere on the board
5V: C10.1, C16.1, C18.1, C20.1, C22.1, C24.1, L2.2, R14.2, U6.1 (VDD), U9.1 (IN); also elsewhere on the board
!BOOTLED: J13.1, R48.1
!OCS1: U9.4 (!FAULT); also elsewhere on the board
!RPIBOOT: J13.3; also elsewhere on the board
+12V: C4.1, C5.1, U7.2 (VIN), U7.3 (EN), U8.2 (VIN), U8.3 (EN); also elsewhere on the board
GND: C4.2, C5.2, C6.2, C7.2, C10.2, C11.2, C12.2, C13.2, C14.2, C17.2, C18.2, C19.2, C20.2, C21.2, C22.2, C23.2 (-), C24.2, C25.2, C26.2, C27.2, J19.1, J19.2, J19.3, R13.1, R15.1, R16.1, U6.5 (GND), U6.11 (THERMAL_PAD), U7.7 (GND), U7.9 (PAD), U8.7 (GND), U8.9 (PAD), U9.2 (GND); also elsewhere on the board
unnamed: J19.6, U6.6 (SET1)
unnamed: C8.2, U7.1 (BST)
unnamed: C8.1, L1.1, U7.8 (SW)
unnamed: C6.1, U7.4 (SS)
unnamed: C11.1, R10.2, U7.6 (COMP)
unnamed: C13.1, R10.1
unnamed: C15.2, R12.1, R13.2, U7.5 (FB)
unnamed: R16.2, U9.5 (ILIM)
unnamed: C9.2, U8.1 (BST)
unnamed: C9.1, L2.1, U8.8 (SW)
unnamed: C7.1, U8.4 (SS)
unnamed: C12.1, R11.2, U8.6 (COMP)
unnamed: C14.1, R11.1
unnamed: C16.2, R14.1, R15.2, U8.5 (FB)
unnamed: J13.2, R9.1, U6.8 (!WD0)
unnamed: LED4.C, R48.2
unnamed: J19.5, U6.3 (SET0)
unnamed: J19.4, U6.4 (CRST)
PWR_EN_USB: U9.3 (EN/!EN); also elsewhere on the board
VBUS: C23.1 (+), C25.1, C26.1, C27.1, U9.6 (OUT); also elsewhere on the board
WTCDG_DIN: U6.7 (WDI); also elsewhere on the board

Notes on the sheet:
12V input to 3.3V 3A output
12V input to 5V 3A output
Edge Device I/O Board Power Section

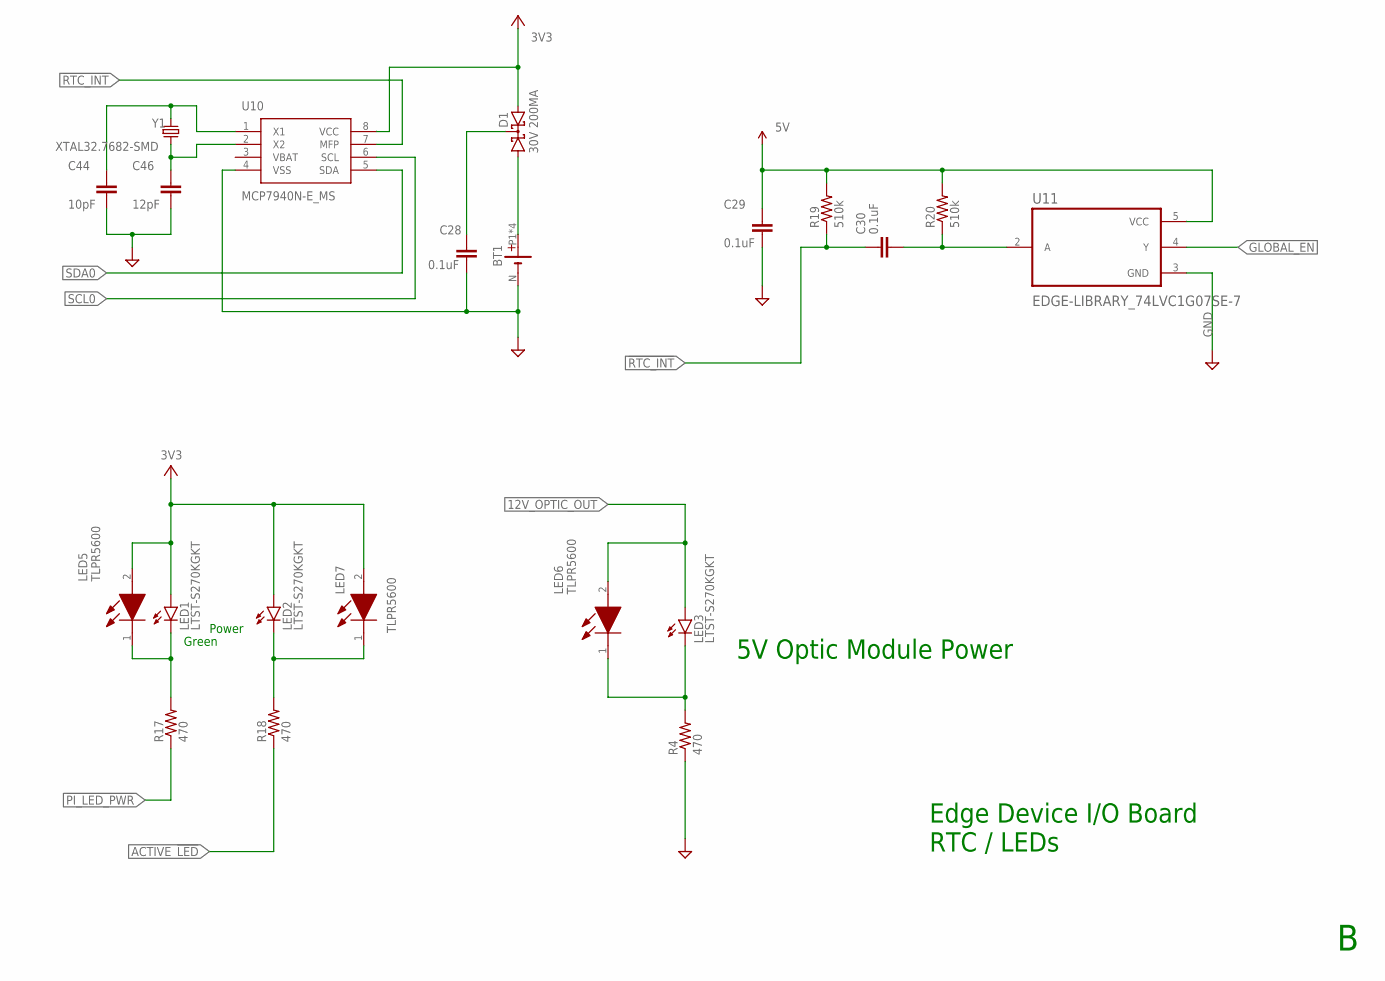
[picture p22: schematic Compute Module.sch, sheet 6]

Parts:
BT1: EDGE-LIBRARY_BATTERY_HOLDER; EDGE-LIBRARY_79523141
C28, C29, C30: 0.1uF; EDGE-LIBRARY_TUTORIAL---FUSION-360_CAPC1005X60; MPN C0402C104K4RACTU; DIGIKEY 399-3521-1-ND
C44: 10pF; EDGE-LIBRARY_TUTORIAL---FUSION-360_CAPC1005X60; MPN 478-04026D100JAT2ACT-ND; DIGIKEY 399-3521-1-ND
C46: 12pF; EDGE-LIBRARY_TUTORIAL---FUSION-360_CAPC1005X60; MPN 04026A120KAT2A; DIGIKEY 478-04026A120KAT2ACT-ND
D1: 30V 200MA; EDGE-LIBRARY_SOT23
LED1, LED2, LED3: LTST-S270KGKT; LED_CHIP-LED0603; MPN LTST-S270KGKT; DIGIKEY LTST-S270KGKT
LED5, LED6, LED7: TLPR5600; TLPP5600; DIGIKEY DNP
R4, R17, R18: 470; EDGE-LIBRARY_TUTORIAL---FUSION-360_RESC1005X40; MPN RC0402FR-07470RL; DIGIKEY 311-470LRCT-ND
R19, R20: 510k; EDGE-LIBRARY_TUTORIAL---FUSION-360_RESC1005X40; MPN RMCF0402JT510K; DIGIKEY RMCF0402JT510KCT-ND
U10: MCP7940N-E_MS; SOP65P490X110-8N
U11: EDGE-LIBRARY_74LVC1G07SE-7; EDGE-LIBRARY_SOT65P210X110-5N
Y1: XTAL32.7682-SMD; XTAL_ECS-.327-12.5-34R-TR; MPN QT3C-32.768KDZY-T; DIGIKEY 3003-QT3C-32.768KDZY-T-ND

Connections:
3V3: D1.2 (A2), LED1.A, LED2.A, LED5.2 (A), LED7.2 (A), U10.8 (VCC); also elsewhere on the board
5V: C29.1, R19.2, R20.2, U11.5 (VCC); also elsewhere on the board
12V_OPTIC_OUT: LED3.A, LED6.2 (A); also elsewhere on the board
!PI_LED_PWR: R17.1; also elsewhere on the board
!RTC_INT: C30.1, R19.1, U10.7 (MFP)
ACTIVE_!LED: R18.1; also elsewhere on the board
GLOBAL_EN: U11.4 (Y); also elsewhere on the board
GND: BT1.N (-), C28.2, C29.2, C44.2, C46.2, R4.1, U10.4 (VSS), U11.3 (GND); also elsewhere on the board
unnamed: C44.1, U10.1 (X1), Y1.2
unnamed: C46.1, U10.2 (X2), Y1.1
unnamed: C28.1, D1.3 (CC)
unnamed: BT1.P1 (+), BT1.P2 (+), BT1.P3 (+), BT1.P4 (+), D1.1 (A1)
unnamed: C30.2, R20.1, U11.2 (A)
unnamed: LED3.C, LED6.1 (K), R4.2
unnamed: LED1.C, LED5.1 (K), R17.2
unnamed: LED2.C, LED7.1 (K), R18.2
SCL0: U10.6 (SCL); also elsewhere on the board
SDA0: U10.5 (SDA); also elsewhere on the board

Notes on the sheet:
Edge Device I/O Board RTC / LEDs
Green
Power
5V Optic Module Power
