mark-parc/edge-carrier-rev-b/Compute Module.brd

## EAGLE design Compute Module.brd (continued)

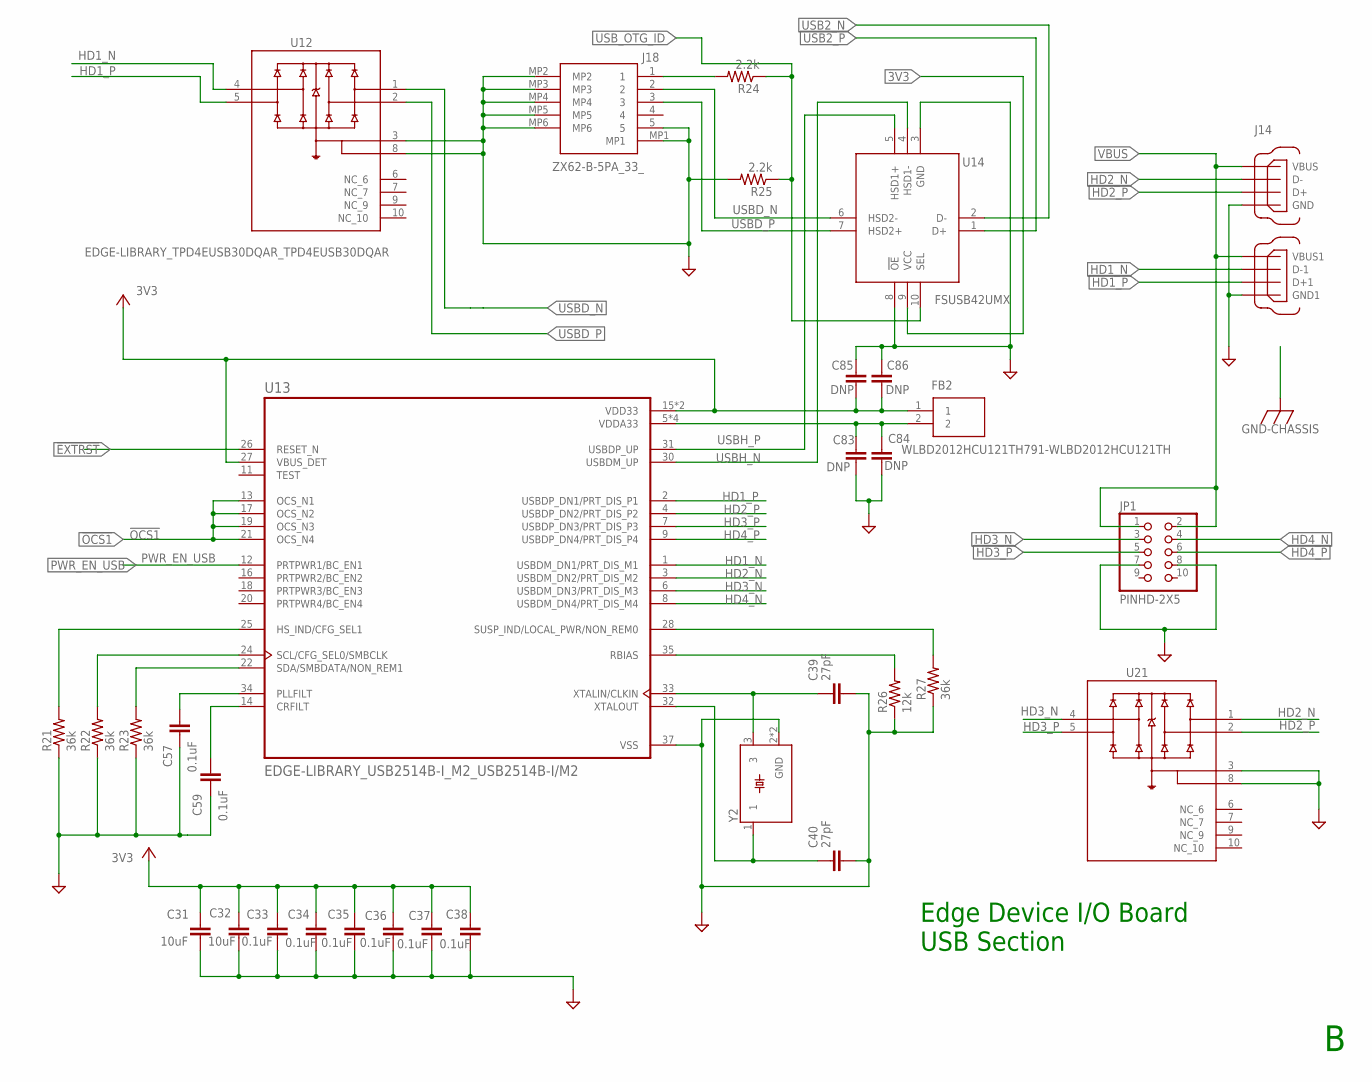
[picture p23: schematic Compute Module.sch, sheet 7]

Parts:
C31, C32: 10uF; EDGE-LIBRARY_TUTORIAL---FUSION-360_CAPC2012X110; MPN GRM21BR71A106KA73K; DIGIKEY 490-14381-1-ND
C33, C34, C35, C36, C37, C38, C57, C59: 0.1uF; EDGE-LIBRARY_TUTORIAL---FUSION-360_CAPC1005X60; MPN C0402C104K4RACTU; DIGIKEY 399-3521-1-ND
C39, C40: 27pF; EDGE-LIBRARY_TUTORIAL---FUSION-360_CAPC1005X60; MPN GJM1555C1H270JB01D; DIGIKEY 490-17672-1-ND
C83, C84, C85, C86: DNP; EDGE-LIBRARY_TUTORIAL---FUSION-360_CAPC1005X60; MPN C0402C104K4RACTU; DIGIKEY 399-3521-1-ND
FB2: WLBD2012HCU121TH791-WLBD2012HCU121TH; EDGE-LIBRARY_0805; MOUSER 791-WLBD2012HCU121TH
J14: EDGE-LIBRARY_USB_A_2PORT_STACKED_SMA; EDGE-LIBRARY_67298-4090_MOLEX_67298-4090
J18: ZX62-B-5PA_33_; ZX62B5PA33
JP1: PINHD-2X5; 2X05; MPN 2011-2X05G00SB; DIGIKEY 2553-2011-2X05G00SB-ND
R21, R22, R23, R27: 36k; EDGE-LIBRARY_TUTORIAL---FUSION-360_RESC1005X40; MPN RC0402FR-0736KL; DIGIKEY 311-36.0KLRCT-ND
R24, R25: 2.2k; EDGE-LIBRARY_TUTORIAL---FUSION-360_RESC1005X40; MPN RM04J222CT; DIGIKEY 2571-RM04J222CTTR-ND
R26: 12k; EDGE-LIBRARY_TUTORIAL---FUSION-360_RESC1005X40; MPN RC0402FR-0712KL; DIGIKEY 311-12.0KLRCT-ND
U12, U21: EDGE-LIBRARY_TPD4EUSB30DQAR_TPD4EUSB30DQAR; EDGE-LIBRARY_TPD4EUSB30DQAR_IC_TPD4EUSB30DQAR
U13: EDGE-LIBRARY_USB2514B-I_M2_USB2514B-I/M2; EDGE-LIBRARY_USB2514B-I_M2_QFN50P600X600X100-37N; DIGIKEY USB2514B-I/M2-ND
U14: FSUSB42UMX; QFN40P140X180X55-10N
Y2: EDGE-LIBRARY_ABM8-24.000MHZ-B2-T_ABM8-24.000MHZ-B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; EDGE-LIBRARY_ABM8-24.000MHZ-B2-T_OSCSC320X250X100N

Connections:
3V3: C31.1, C32.1, C33.1, C34.1, C35.1, C36.1, C37.1, C38.1, C85.2, C86.2, FB2.1, U13.15 (VDD33), U13.23 (VDD33), U13.27 (VBUS_DET), U14.9 (VCC); also elsewhere on the board
!EXTRST: U13.26 (RESET_N); also elsewhere on the board
!OCS1: U13.13 (OCS_N1), U13.17 (OCS_N2), U13.19 (OCS_N3), U13.21 (OCS_N4); also elsewhere on the board
GND: C31.2, C32.2, C33.2, C34.2, C35.2, C36.2, C37.2, C38.2, C39.2, C40.2, C57.1, C59.1, C83.2, C84.2, C85.1, C86.1, J14.4 (GND1), J14.8 (GND), J18.5, J18.MP1, J18.MP2, J18.MP3, J18.MP4, J18.MP5, J18.MP6, JP1.7, JP1.8, R21.1, R22.1, R23.1, R25.2, R26.1, R27.1, U12.3 (GND_3), U12.8 (GND_8), U13.37 (VSS), U14.3 (GND), U14.8 (!OE), U21.3 (GND_3), U21.8 (GND_8), Y2.2 (GND), Y2.4 (GND); also elsewhere on the board
HD1_N: J14.2 (D-1), U12.4 (D2+), U13.1 (USBDM_DN1/PRT_DIS_M1)
HD1_P: J14.3 (D+1), U12.5 (D2-), U13.2 (USBDP_DN1/PRT_DIS_P1)
HD2_N: J14.6 (D-), U13.3 (USBDM_DN2/PRT_DIS_M2), U21.1 (D1+)
HD2_P: J14.7 (D+), U13.4 (USBDP_DN2/PRT_DIS_P2), U21.2 (D1-)
HD3_N: JP1.3, U13.6 (USBDM_DN3/PRT_DIS_M3), U21.4 (D2+)
HD3_P: JP1.5, U13.7 (USBDP_DN3/PRT_DIS_P3), U21.5 (D2-)
HD4_N: JP1.4, U13.8 (USBDM_DN4/PRT_DIS_M4); also elsewhere on the board
HD4_P: JP1.6, U13.9 (USBDP_DN4/PRT_DIS_P4); also elsewhere on the board
unnamed: R23.2, U13.22 (SDA/SMBDATA/NON_REM1)
unnamed: R22.2, U13.24 (SCL/CFG_SEL0/SMBCLK)
unnamed: R21.2, U13.25 (HS_IND/CFG_SEL1)
unnamed: R27.2, U13.28 (SUSP_IND/LOCAL_PWR/NON_REM0)
unnamed: R26.2, U13.35 (RBIAS)
unnamed: C39.1, U13.33 (XTALIN/CLKIN), Y2.3
unnamed: C40.1, U13.32 (XTALOUT), Y2.1
unnamed: J18.1, R24.2
unnamed: C57.2, U13.34 (PLLFILT)
unnamed: C59.2, U13.14 (CRFILT)
unnamed: C83.1, C84.1, FB2.2, U13.5 (VDDA33), U13.10 (VDDA33), U13.29 (VDDA33), U13.36 (VDDA33)
PWR_EN_USB: U13.12 (PRTPWR1/BC_EN1); also elsewhere on the board
USB2_N: U14.2 (D-); also elsewhere on the board
USB2_P: U14.1 (D+); also elsewhere on the board
USBD_N: J18.2, U12.1 (D1+), U14.6 (HSD2-)
USBD_P: J18.3, U12.2 (D1-), U14.7 (HSD2+)
USBH_N: U13.30 (USBDM_UP), U14.4 (HSD1-)
USBH_P: U13.31 (USBDP_UP), U14.5 (HSD1+)
USB_OTG_ID: R24.1, R25.1, U14.10 (SEL); also elsewhere on the board
VBUS: J14.1 (VBUS1), J14.5 (VBUS), JP1.1, JP1.2; also elsewhere on the board

Notes on the sheet:
Edge Device I/O Board USB Section

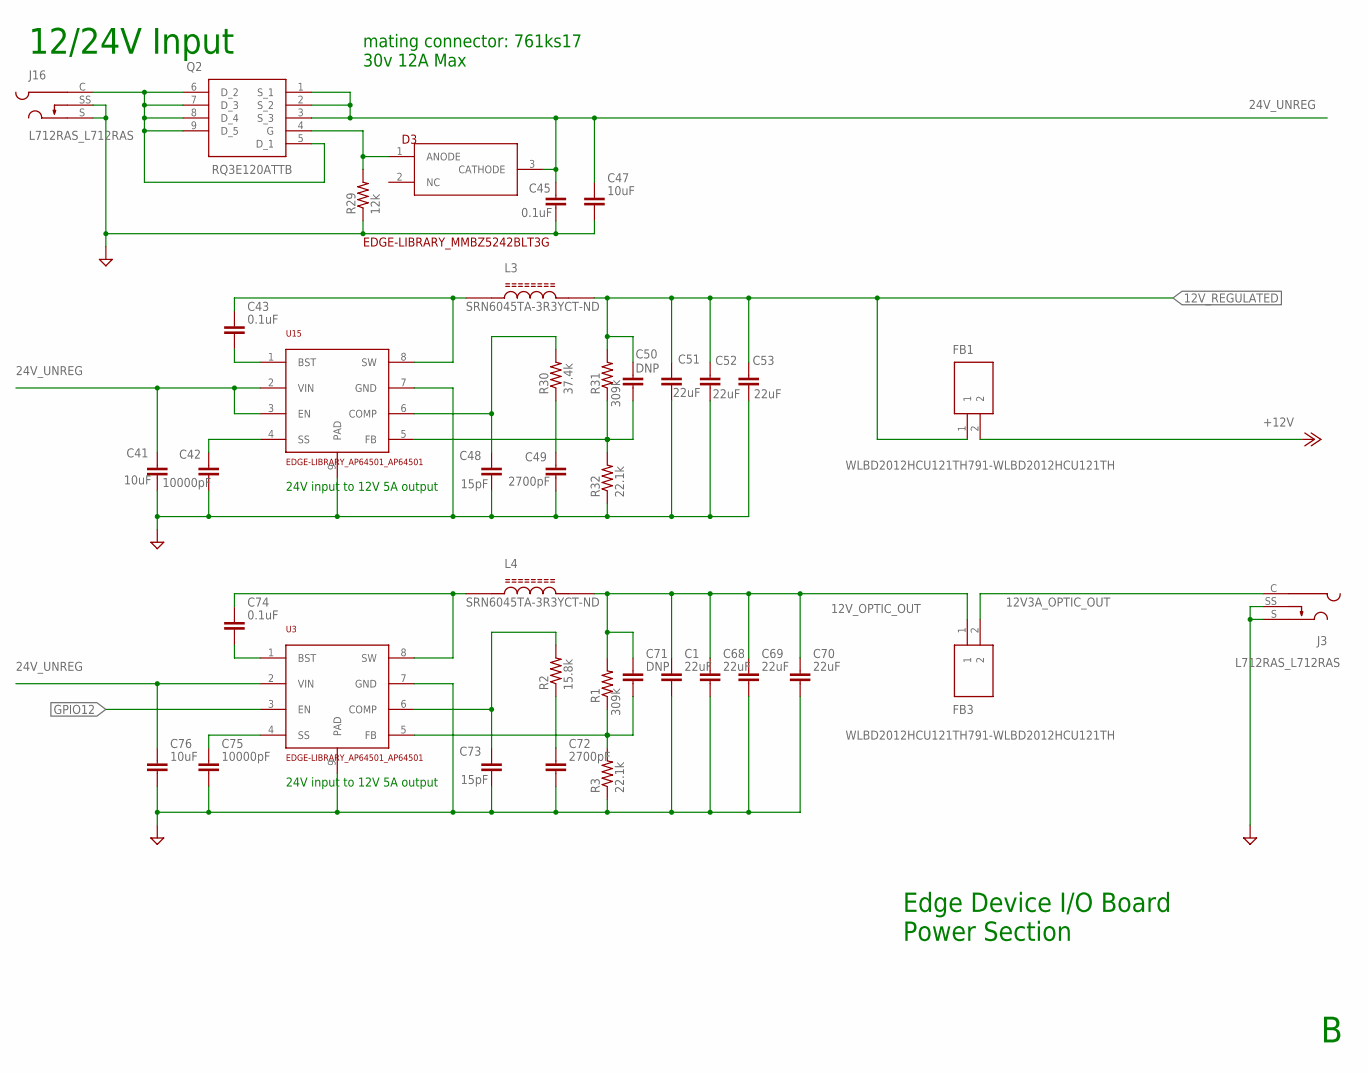
[picture p24: schematic Compute Module.sch, sheet 8]

Parts:
C1, C51, C52, C53, C68, C69, C70: 22uF; EDGE-LIBRARY_TUTORIAL---FUSION-360_CAPC1005X60; MPN GMC04X5R226M6R3NT; DIGIKEY 2571-GMC04X5R226M6R3NTTR-ND
C41, C47, C76: 10uF; EDGE-LIBRARY_TUTORIAL---FUSION-360_CAPC2012X110; MPN GRM21BR71A106KA73K; DIGIKEY 490-14381-1-ND
C42, C75: 10000pF; EDGE-LIBRARY_TUTORIAL---FUSION-360_CAPC1005X60; MPN CM02X5R103M16AH; DIGIKEY 1253-CM02X5R103M16AHCT-ND
C43, C45, C74: 0.1uF; EDGE-LIBRARY_TUTORIAL---FUSION-360_CAPC1005X60; MPN C0402C104K4RACTU; DIGIKEY 399-3521-1-ND
C48, C73: 15pF; EDGE-LIBRARY_TUTORIAL---FUSION-360_CAPC1005X60; MPN GMC04CG150J50NT; DIGIKEY 2571-GMC04CG150J50NTTR-ND
C49, C72: 2700pF; EDGE-LIBRARY_TUTORIAL---FUSION-360_CAPC1005X60; MPN GMC04X5R272M50NT; DIGIKEY 2571-GMC04X5R272M50NTTR-ND
C50, C71: DNP; EDGE-LIBRARY_TUTORIAL---FUSION-360_CAPC1005X60
D3: EDGE-LIBRARY_MMBZ5242BLT3G; EDGE-LIBRARY_SOT23
FB1: WLBD2012HCU121TH791-WLBD2012HCU121TH; EDGE-LIBRARY_0805; MOUSER 791-WLBD2012HCU121TH
FB3: WLBD2012HCU121TH791-WLBD2012HCU121TH; EDGE-LIBRARY_0805
J3, J16: L712RAS_L712RAS; L712RAS_SWITCHCRAFT_L712RAS; DIGIKEY SC1394-ND
L3, L4: EDGE-LIBRARY_SRN6045TA-3R3Y_SRN6045TA-3R3Y; EDGE-LIBRARY_SRN6045TA-3R3Y_IND_SRN6045TA-3R3Y
Q2: RQ3E120ATTB; RQ3E100ATTB
R1, R31: 309k; EDGE-LIBRARY_TUTORIAL---FUSION-360_RESC1005X40; MPN RM04F3093CT; DIGIKEY 2571-RM04F3093CTTR-ND
R2: 15.8k; EDGE-LIBRARY_TUTORIAL---FUSION-360_RESC1005X40; MPN CRCW040215K8FKED; DIGIKEY 541-15.8KLCT-ND
R3, R32: 22.1k; EDGE-LIBRARY_TUTORIAL---FUSION-360_RESC1005X40; MPN RN04D2212CT10-25; DIGIKEY 2571-RN04D2212CT10-25TR-ND
R29: 12k; EDGE-LIBRARY_TUTORIAL---FUSION-360_RESC1005X40; MPN RC0402FR-0712KL; DIGIKEY 311-12.0KLRCT-ND
R30: 37.4k; EDGE-LIBRARY_TUTORIAL---FUSION-360_RESC1005X40; MPN RM04F3742CT; DIGIKEY 2571-RM04F3742CTTR-ND
U3, U15: EDGE-LIBRARY_AP64501_AP64501; EDGE-LIBRARY_AP64501_SOIC127P600X265-9T261X350N

Connections:
12V3A_OPTIC_OUT: FB3.2, J3.C (CENTRE_PIN)
12V_OPTIC_OUT: C1.1, C68.1, C69.1, C70.1, C71.1, FB3.1, L4.2, R1.2; also elsewhere on the board
12V_REGULATED: C50.1, C51.1, C52.1, C53.1, FB1.1, L3.2, R31.2
24V_UNREG: C41.1, C45.1, C47.1, C76.1, D3.3 (CATHODE), Q2.1 (S_1), Q2.2 (S_2), Q2.3 (S_3), U3.2 (VIN), U15.2 (VIN), U15.3 (EN)
+12V: FB1.2; also elsewhere on the board
GND: C1.2, C41.2, C42.2, C45.2, C47.2, C48.2, C49.2, C51.2, C52.2, C53.2, C68.2, C69.2, C70.2, C72.2, C73.2, C75.2, C76.2, J3.S (SLEEVE), J3.SS (SLEEVE_SHUNT), J16.S (SLEEVE), J16.SS (SLEEVE_SHUNT), R3.1, R29.1, R32.1, U3.7 (GND), U3.9 (PAD), U15.7 (GND), U15.9 (PAD); also elsewhere on the board
GPIO12: U3.3 (EN); also elsewhere on the board
unnamed: C43.2, U15.1 (BST)
unnamed: C74.2, U3.1 (BST)
unnamed: C74.1, L4.1, U3.8 (SW)
unnamed: C75.1, U3.4 (SS)
unnamed: C73.1, R2.2, U3.6 (COMP)
unnamed: C72.1, R2.1
unnamed: C71.2, R1.1, R3.2, U3.5 (FB)
unnamed: C43.1, L3.1, U15.8 (SW)
unnamed: C42.1, U15.4 (SS)
unnamed: C48.1, R30.2, U15.6 (COMP)
unnamed: C49.1, R30.1
unnamed: C50.2, R31.1, R32.2, U15.5 (FB)
unnamed: J16.C (CENTRE_PIN), Q2.5 (D_1), Q2.6 (D_2), Q2.7 (D_3), Q2.8 (D_4), Q2.9 (D_5)
unnamed: D3.1 (ANODE), Q2.4 (G), R29.2

Notes on the sheet:
24V input to 12V 5A output
Edge Device I/O Board Power Section
mating connector: 761ks17 30v 12A Max
12/24V Input

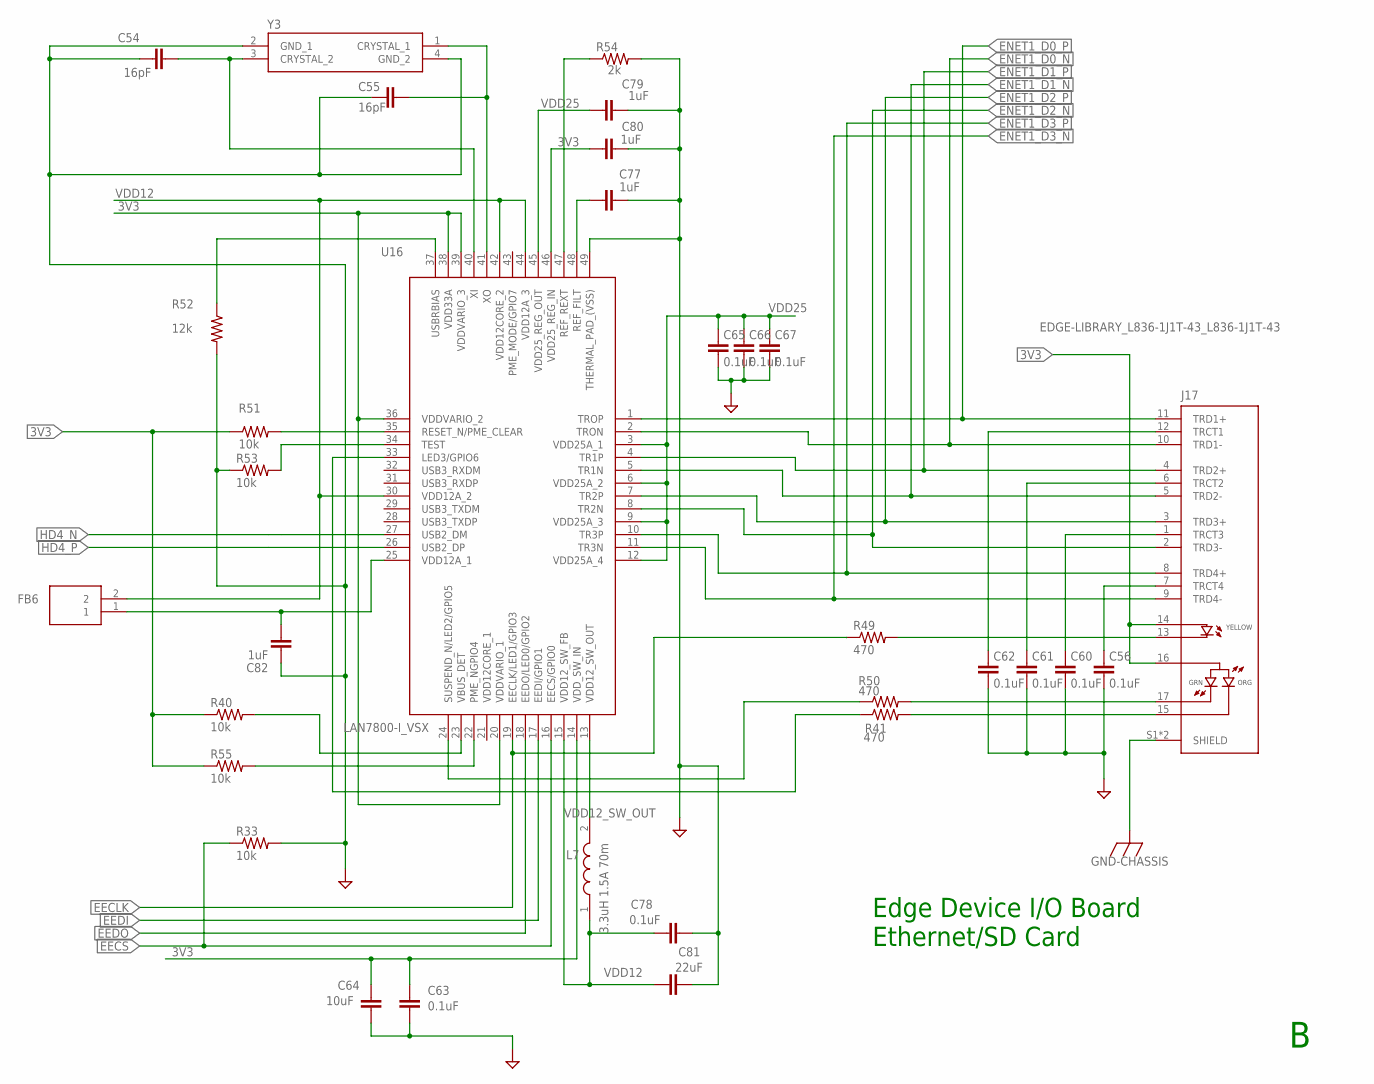
[picture p25: schematic Compute Module.sch, sheet 9]

Parts:
C54, C55: 16pF; EDGE-LIBRARY_TUTORIAL---FUSION-360_CAPC1005X60; MPN C0402C160K3HACAUTO; DIGIKEY 399-C0402C160K3HACAUTOCT-ND
C56, C60, C61, C62, C63, C65, C66, C67, C78: 0.1uF; EDGE-LIBRARY_TUTORIAL---FUSION-360_CAPC1005X60; MPN C0402C104K4RACTU; DIGIKEY 399-3521-1-ND
C64: 10uF; EDGE-LIBRARY_TUTORIAL---FUSION-360_CAPC2012X110; MPN GRM21BR71A106KA73K; DIGIKEY 490-14381-1-ND
C77, C79, C80, C82: 1uF; EDGE-LIBRARY_TUTORIAL---FUSION-360_CAPC1005X60; MPN C0402B105K016T; DIGIKEY 2873-C0402B105K016TCT-ND
C81: 22uF; EDGE-LIBRARY_TUTORIAL---FUSION-360_CAPC1005X60; MPN GMC04X5R226M6R3NT; DIGIKEY 2571-GMC04X5R226M6R3NTTR-ND
FB6: SAMACSYS_PARTS_BLM18PG121SN1D; SAMACSYS_PARTS_BLM18AG102BH1D; DIGIKEY 490-1037-1-ND
J17: EDGE-LIBRARY_L836-1J1T-43_L836-1J1T-43; EDGE-LIBRARY_L836-1J1T-43_BEL_L836-1J1T-43
L7: 3.3uH 1.5A 70m; INDPM3030X150N
R33, R40, R51, R53, R55: 10k; EDGE-LIBRARY_TUTORIAL---FUSION-360_RESC1005X40; MPN RM04J103CT; DIGIKEY 2571-RM04J103CTTR-ND
R41, R49, R50: 470; EDGE-LIBRARY_TUTORIAL---FUSION-360_RESC1005X40; MPN RC0402FR-07470RL; DIGIKEY 311-470LRCT-ND
R52: 12k; EDGE-LIBRARY_TUTORIAL---FUSION-360_RESC1005X40; MPN RC0402FR-0712KL; DIGIKEY 311-12.0KLRCT-ND
R54: 2k; EDGE-LIBRARY_TUTORIAL---FUSION-360_RESC1005X40; MPN RMCF0402JT2K00; DIGIKEY RMCF0402JT2K00CT-ND
U16: LAN7800-I_VSX; QFN40P600X600X90-49N
Y3: SAMACSYS_PARTS_ABM8G-25.000MHZ-B4Y-T3; SAMACSYS_PARTS_ABM8G48000MHZ18D2YT; DIGIKEY 535-14315-1-ND

Connections:
3V3: C63.1, C64.1, C80.1, J17.14, J17.16, R40.1, R51.1, R55.1, U16.14 (VDD_SW_IN), U16.20 (VDDVARIO_1), U16.36 (VDDVARIO_2), U16.38 (VDD33A), U16.39 (VDDVARIO_3), U16.46 (VDD25_REG_IN); also elsewhere on the board
CGND: J17.S1 (SHIELD), J17.S2 (SHIELD); also elsewhere on the board
EECLK: R49.1, U16.19 (EECLK/LED1/GPIO3); also elsewhere on the board
EECS: R33.1, U16.16 (EECS/GPIO0); also elsewhere on the board
EEDI: U16.17 (EEDI/GPIO1); also elsewhere on the board
EEDO: U16.18 (EEDO/LED0/GPIO2); also elsewhere on the board
ENET1_D0_N: J17.10 (TRD1-), U16.2 (TRON); also elsewhere on the board
ENET1_D0_P: J17.11 (TRD1+), U16.1 (TROP); also elsewhere on the board
ENET1_D1_N: J17.5 (TRD2-), U16.5 (TR1N); also elsewhere on the board
ENET1_D1_P: J17.4 (TRD2+), U16.4 (TR1P); also elsewhere on the board
ENET1_D2_N: J17.2 (TRD3-), U16.8 (TR2N); also elsewhere on the board
ENET1_D2_P: J17.3 (TRD3+), U16.7 (TR2P); also elsewhere on the board
ENET1_D3_N: J17.9 (TRD4-), U16.11 (TR3N); also elsewhere on the board
ENET1_D3_P: J17.8 (TRD4+), U16.10 (TR3P); also elsewhere on the board
GND: C54.1, C55.2, C56.2, C60.2, C61.2, C62.2, C63.2, C64.2, C65.2, C66.2, C67.2, C77.2, C78.2, C79.2, C80.2, C81.2, C82.1, R33.2, R52.2, R53.1, R54.2, U16.49 (THERMAL_PAD_(VSS)), Y3.2 (GND_1), Y3.4 (GND_2); also elsewhere on the board
HD4_N: U16.27 (USB2_DM); also elsewhere on the board
HD4_P: U16.26 (USB2_DP); also elsewhere on the board
unnamed: J17.13, R49.2
unnamed: J17.17, R50.2
unnamed: J17.15, R41.2
unnamed: R40.2, U16.23 (VBUS_DET)
unnamed: R51.2, U16.35 (RESET_N/PME_CLEAR)
unnamed: C54.2, U16.40 (XI), Y3.3 (CRYSTAL_2)
unnamed: C55.1, U16.41 (XO), Y3.1 (CRYSTAL_1)
unnamed: R52.1, U16.37 (USBRBIAS)
unnamed: R53.2, U16.34 (TEST)
unnamed: R54.1, U16.47 (REF_REXT)
unnamed: C77.1, U16.48 (REF_FILT)
unnamed: R55.2, U16.22 (PME_NGPIO4)
unnamed: C82.2, FB6.1, U16.25 (VDD12A_1)
unnamed: C62.1, J17.12 (TRCT1)
unnamed: C61.1, J17.6 (TRCT2)
unnamed: C60.1, J17.1 (TRCT3)
unnamed: C56.1, J17.7 (TRCT4)
unnamed: R50.1, U16.24 (SUSPEND_N/LED2/GPIO5)
unnamed: R41.1, U16.33 (LED3/GPIO6)
VDD12: C78.1, C81.1, FB6.2, L7.1, U16.15 (VDD12_SW_FB), U16.30 (VDD12A_2), U16.42 (VDD12CORE_2), U16.44 (VDD12A_3)
VDD12_SW_OUT: L7.2, U16.13 (VDD12_SW_OUT)
VDD25: C65.1, C66.1, C67.1, C79.1, U16.3 (VDD25A_1), U16.6 (VDD25A_2), U16.9 (VDD25A_3), U16.12 (VDD25A_4), U16.45 (VDD25_REG_OUT)

Notes on the sheet:
Edge Device I/O Board Ethernet/SD Card

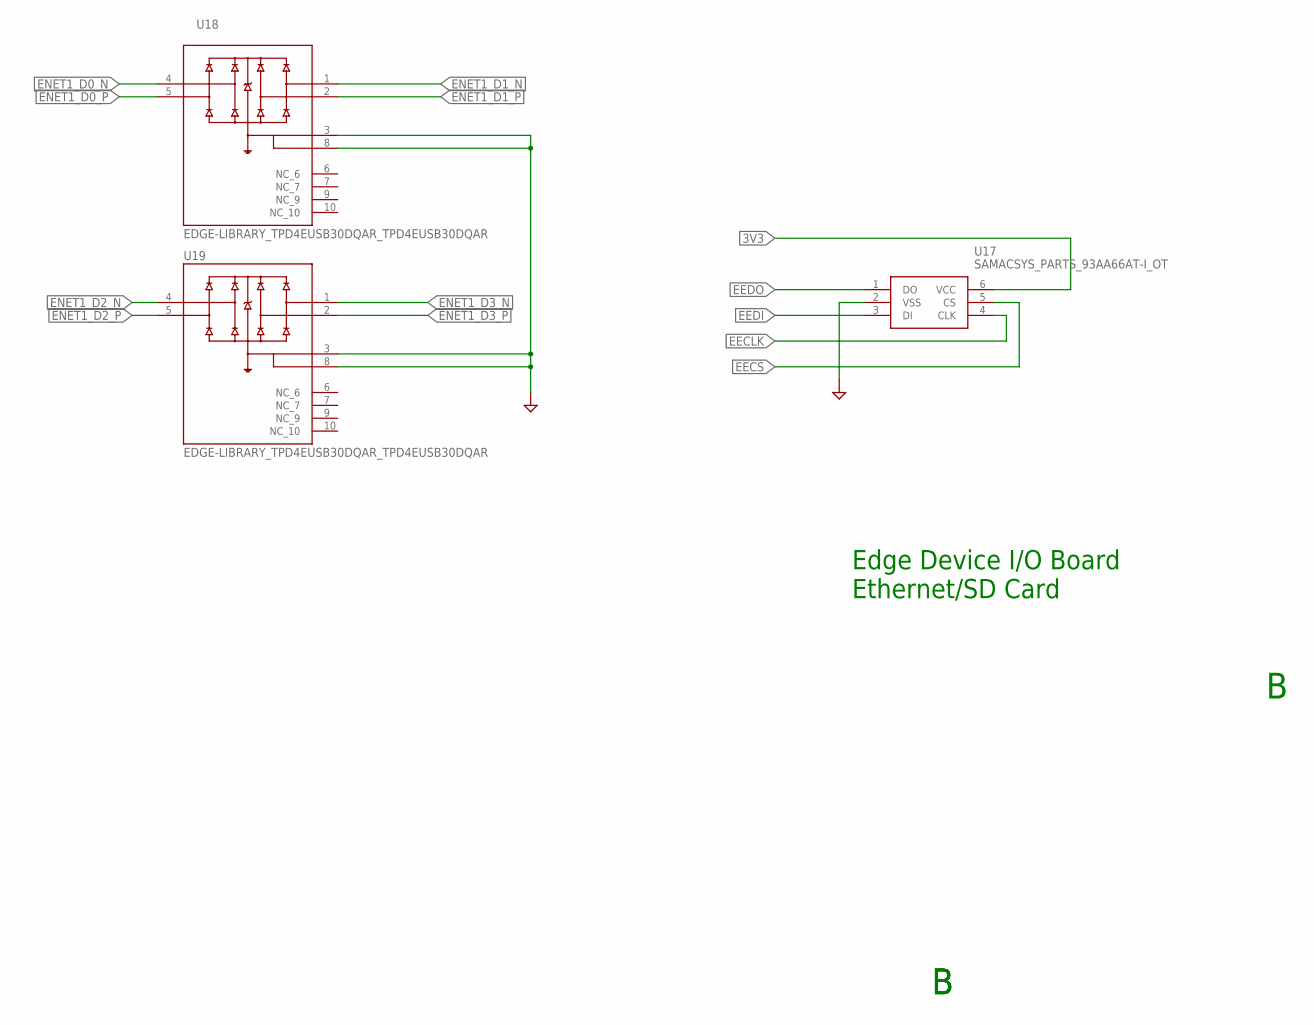
[picture p26: schematic Compute Module.sch, sheet 10]

Parts:
U17: SAMACSYS_PARTS_93AA66AT-I_OT; SAMACSYS_PARTS_SOT95P270X145-6N; DIGIKEY 93AA66AT-I/OTCT-ND
U18, U19: EDGE-LIBRARY_TPD4EUSB30DQAR_TPD4EUSB30DQAR; EDGE-LIBRARY_TPD4EUSB30DQAR_IC_TPD4EUSB30DQAR

Connections:
3V3: U17.6 (VCC); also elsewhere on the board
EECLK: U17.4 (CLK); also elsewhere on the board
EECS: U17.5 (CS); also elsewhere on the board
EEDI: U17.3 (DI); also elsewhere on the board
EEDO: U17.1 (DO); also elsewhere on the board
ENET1_D0_N: U18.4 (D2+); also elsewhere on the board
ENET1_D0_P: U18.5 (D2-); also elsewhere on the board
ENET1_D1_N: U18.1 (D1+); also elsewhere on the board
ENET1_D1_P: U18.2 (D1-); also elsewhere on the board
ENET1_D2_N: U19.4 (D2+); also elsewhere on the board
ENET1_D2_P: U19.5 (D2-); also elsewhere on the board
ENET1_D3_N: U19.1 (D1+); also elsewhere on the board
ENET1_D3_P: U19.2 (D1-); also elsewhere on the board
GND: U17.2 (VSS), U18.3 (GND_3), U18.8 (GND_8), U19.3 (GND_3), U19.8 (GND_8); also elsewhere on the board

Notes on the sheet:
Edge Device I/O Board Ethernet/SD Card

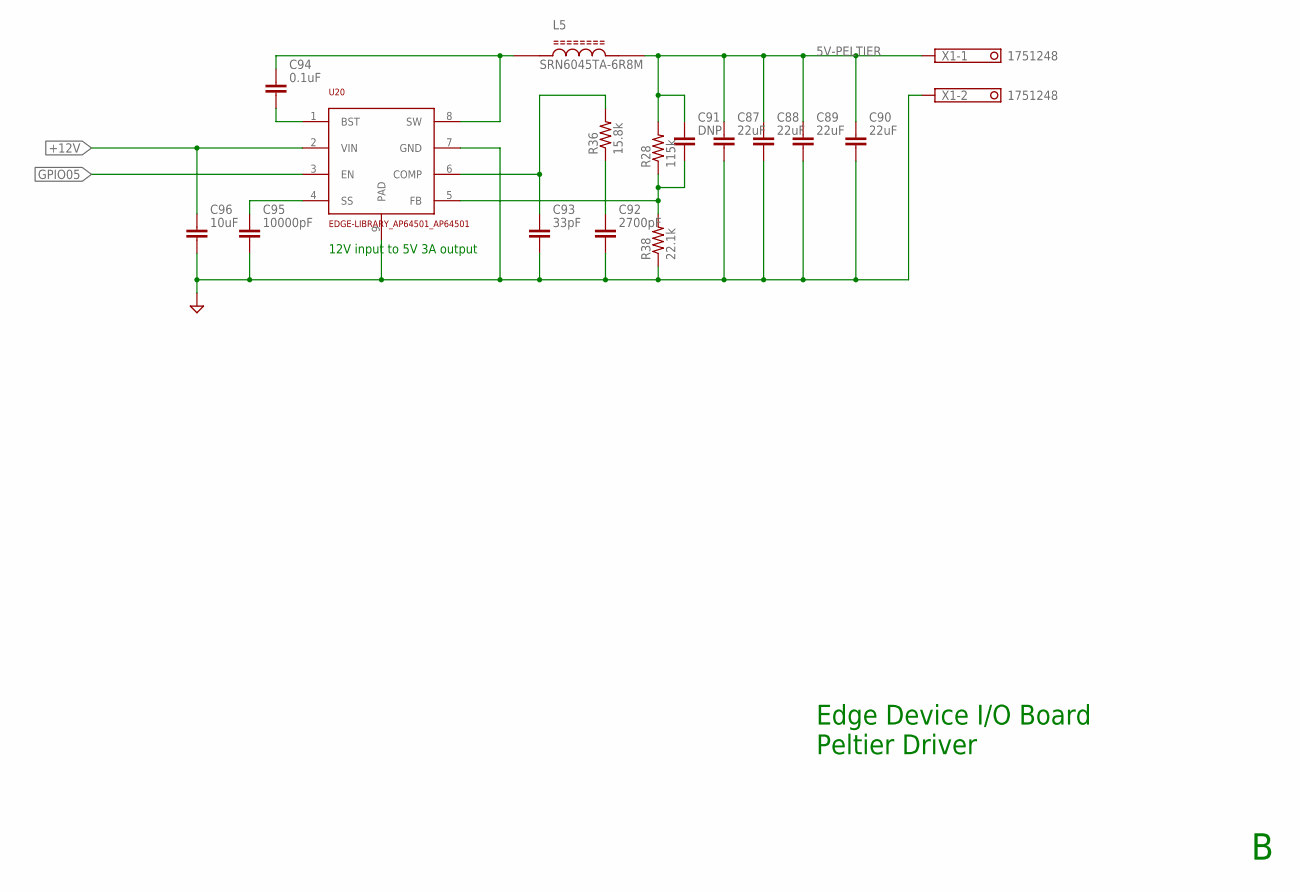
[picture p27: schematic Compute Module.sch, sheet 11]

Parts:
C87, C88, C89, C90: 22uF; EDGE-LIBRARY_TUTORIAL---FUSION-360_CAPC1005X60; MPN GMC04X5R226M6R3NT; DIGIKEY 2571-GMC04X5R226M6R3NTTR-ND
C91: DNP; EDGE-LIBRARY_TUTORIAL---FUSION-360_CAPC1005X60
C92: 2700pF; EDGE-LIBRARY_TUTORIAL---FUSION-360_CAPC1005X60; MPN GMC04X5R272M50NT; DIGIKEY 2571-GMC04X5R272M50NTTR-ND
C93: 33pF; EDGE-LIBRARY_TUTORIAL---FUSION-360_CAPC1005X60; MPN GMC04CG330J16NT; DIGIKEY 2571-GMC04CG330J16NTTR-ND
C94: 0.1uF; EDGE-LIBRARY_TUTORIAL---FUSION-360_CAPC1005X60; MPN C0402C104K4RACTU; DIGIKEY 399-3521-1-ND
C95: 10000pF; EDGE-LIBRARY_TUTORIAL---FUSION-360_CAPC1005X60; MPN CM02X5R103M16AH; DIGIKEY 1253-CM02X5R103M16AHCT-ND
C96: 10uF; EDGE-LIBRARY_TUTORIAL---FUSION-360_CAPC2012X110; MPN GRM21BR71A106KA73K; DIGIKEY 490-14381-1-ND
L5: EDGE-LIBRARY_SRN6045TA-3R3Y_SRN6045TA-3R3Y; EDGE-LIBRARY_SRN6045TA-3R3Y_IND_SRN6045TA-3R3Y; MPN SRN6045TA-6R8M; DIGIKEY SRN6045TA-6R8MCT-ND
R28: 115k; EDGE-LIBRARY_TUTORIAL---FUSION-360_RESC1005X40; MPN RP73PF1E115KBTD; DIGIKEY A127517CT-ND
R36: 15.8k; EDGE-LIBRARY_TUTORIAL---FUSION-360_RESC1005X40; MPN CRCW040215K8FKED; DIGIKEY 541-15.8KLCT-ND
R38: 22.1k; EDGE-LIBRARY_TUTORIAL---FUSION-360_RESC1005X40; MPN RN04D2212CT10-25; DIGIKEY 2571-RN04D2212CT10-25TR-ND
U20: EDGE-LIBRARY_AP64501_AP64501; EDGE-LIBRARY_AP64501_SOIC127P600X265-9T261X350N
X1: 1751248

Connections:
5V-PELTIER: C87.1, C88.1, C89.1, C90.1, C91.1, L5.2, R28.2, X1.1
+12V: C96.1, U20.2 (VIN); also elsewhere on the board
GND: C87.2, C88.2, C89.2, C90.2, C92.2, C93.2, C95.2, C96.2, R38.1, U20.7 (GND), U20.9 (PAD), X1.2; also elsewhere on the board
GPIO05: U20.3 (EN); also elsewhere on the board
unnamed: C94.2, U20.1 (BST)
unnamed: C94.1, L5.1, U20.8 (SW)
unnamed: C95.1, U20.4 (SS)
unnamed: C93.1, R36.2, U20.6 (COMP)
unnamed: C92.1, R36.1
unnamed: C91.2, R28.1, R38.2, U20.5 (FB)

Notes on the sheet:
Edge Device I/O Board Peltier Driver
12V input to 5V 3A output

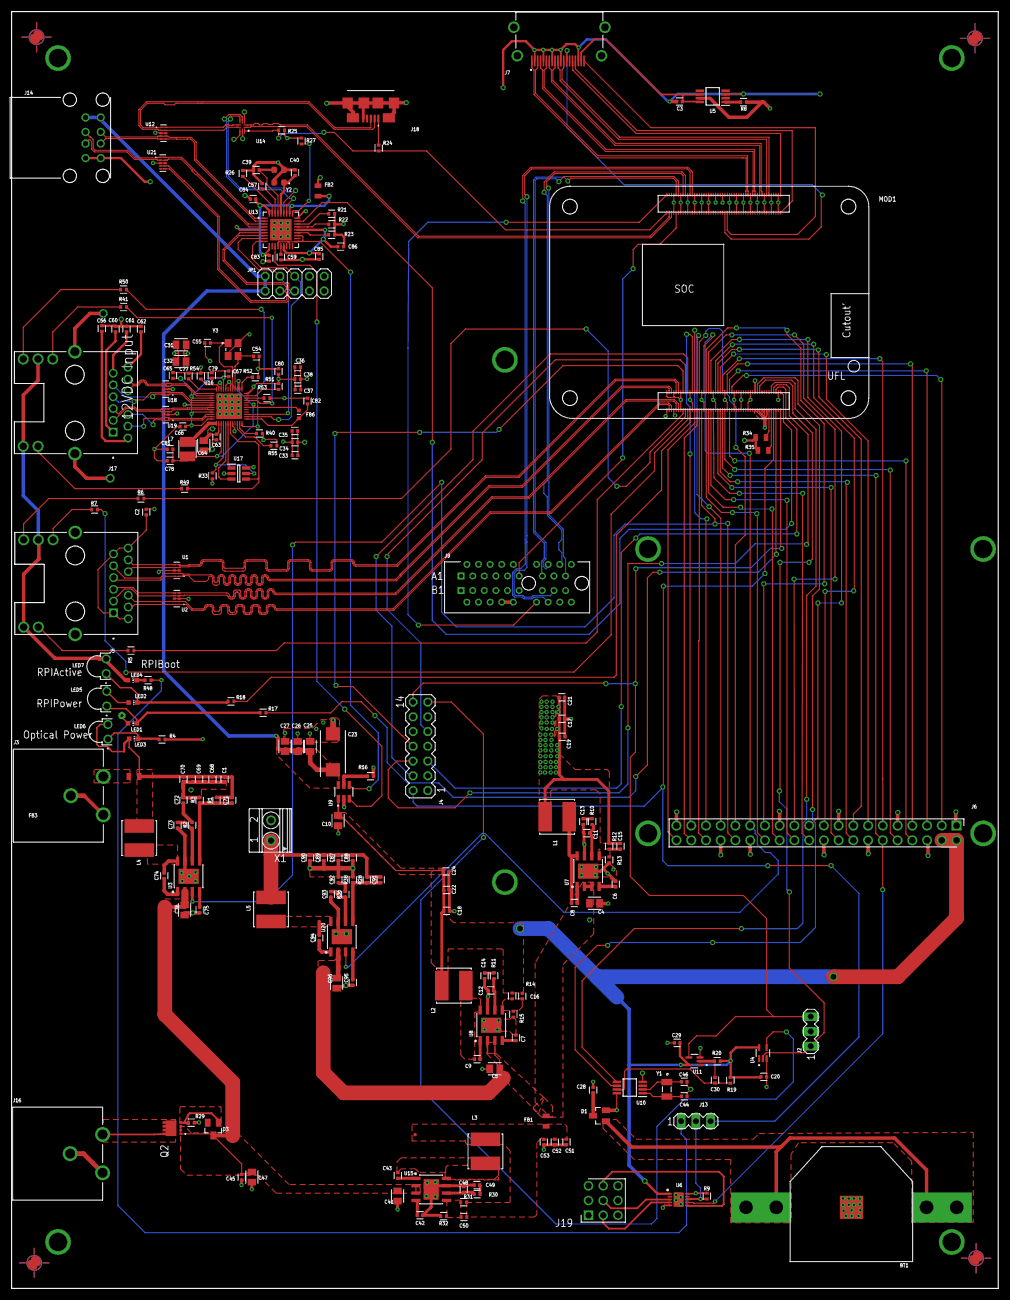
[picture p28: board Compute Module.brd from above]

Board: 4 copper layers, 170.0 x 220.0 mm, 217 parts (0 on the bottom side), 203 nets.

Other parts of the board:
U$1, U$3, U$4, U$8: PASS-ROUND
