mark-parc/edge-carrier-rev-b/(commit log)

2022-02-08 Edge Carrier Rev B Schematics and PCB files
    [Compute Module.brd, Compute Module.dxf, Compute Module.sch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]
2022-02-18 Added gerbers
    [Board FAB Information.xlsx, Compute Module BOM.xlsx, Compute Module.csv, In House Eloque BOM materials.xlsx, ViewMate.cfg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]
